the-Drunken-coder/dual-band-radio-lab/hardware/carrier-rev-a/README.md

# carrier-rev-a

Editable Rev A schematic, routed PCB, selected BOM and schematic PDF. Native KiCad ERC and DRC pass with zero findings, including schematic parity. Two layers, 2 oz copper per side. Review only; no manufacturing release.

Open [carrier-rev-a.kicad_pcb](carrier-rev-a.kicad_pcb) in KiCad. The final native board is authoritative; do not overwrite it with the intermediate router session. See the hardware DESIGN_REVIEW.md, POWER_BUDGET.md and ASSEMBLY_NOTES.md for access, route lengths, power estimates and later physical acceptance.
