the-Drunken-coder/dual-band-radio-lab/hardware/FOOTPRINT_REVIEW.md

# Footprint and component review

Reviewed 2026-09-17 against manufacturer drawings and the actual KiCad 10.0.6 library files. `validation/footprint-geometry.json` records pad numbers, coordinates, sizes and finished drill diameters read by KiCad's footprint loader. Custom and standard footprints are now placed in the four routed review boards. Standard-library names alone were not treated as dimensional evidence.

All coordinates below are mm. Pad dimensions are copper, not solder-mask openings. Library land patterns are engineering choices unless explicitly identified as manufacturer recommendations. Board-level courtyard/access review is recorded in DESIGN_REVIEW.md; fabrication process acceptance remains pending.

| Selected part / footprint | Manufacturer check | Actual footprint and disposition |
| --- | --- | --- |
| Samtec SSQ-108/110/120-01-G-S | SSQ drawing Rev BH: 2.54 pitch, 2.41 body width, length N x 2.54 + 0.51, 8.51 body height, 2.64 solder tail. SSQ PCB drawing: 1.02 holes | Custom SSQ rows use 1.02 finished holes and 1.90 lands; body dimensions match. Carrier slot 8/10 and Pico 20 positions; Core sockets 8 positions |
| Samtec TSW-108/110-07-G-S | TSW drawing Rev DS: 2.54 pitch/body height/width, 5.84 mating post, 2.54 solder tail. Manufacturer footprint: 1.02 holes | Custom TSW rows use 1.02 holes/1.90 lands. Standard fully populated parts, no omitted-pin key |
| Pico 2 with headers SC1632 | Pico 2 mechanical drawing: 21 x 51 board, 2.54 pitch, 17.78 between header rows | No module land pattern: plug-in U1 and two real SSQ-120 sockets. Left J10 1-20 follows Pico 1-20; right J11 1-20 follows Pico 21-40. Right socket runs in the opposite geometric direction in top view, so J11 pin 20 is beside USB |
| Core2021-HF-M, Waveshare SKU 34523 | Waveshare 2D drawing: 22.01 x 18.45 board, 2.54 pitch, 15.24 between rows; vendor schematic U2 header numbers | Plug-in module, two SSQ-108 sockets. J3 1-8 maps module 1-8, J4 1-8 maps 9-16. Preserve the module top-view numbering, with the opposing row reversed geometrically |
| E22-900M30S / RadioLab:E22_900M30S | Ebyte manual PDF p10, section 3.3: 24 x 38.5, groups at 2.54 pitch with 7.60 group gap; terminal contact 1.25 x 1.5 | Top-view pin 12 at upper left, 11 upper right, counts toward 22/1 at lower end. Edge-centered lands 2.50 x 1.80 extend 1.25 beyond module. First y=2.61. Chained bottom pad is y=33.07; the separately rounded 5.46 bottom dimension gives 33.04. The 0.03 discrepancy is inside the drawing's 0.1 tolerance and the enlarged lands. Do not use a generic E22 footprint |
| E28-2G4M27S / RadioLab:E28_2G4M27S | Exact 27S manual PDF p5: 15 x 26.5, 1.27 pitch, terminal 1.0 x 0.8, first pad offset 2.69 | Left pins 1-8, right 16-9. Edge lands 2.00 x 0.90. Last y=11.58; separately rounded bottom dimension differs by 0.02. The download labeled 12S/20S was not reused. Preserve module antenna clearance and underside routing restrictions |
| Phoenix Contact 1757242 | Manufacturer dimensional data: 12.16 width, 12 depth, 8.57 installed height, 5.08 pitch, 1 x 1 tails and 1.4 hole | Exact named KiCad horizontal footprint: 5.08 pitch, 1.4 drill, 2.08 x 3.60 pads. 1757019 is the manufacturer-listed cable mate; no PCB footprint for the cable plug |
| TPS259470LRPWR | TI RPW0010A, PDF pp72-73: 2 x 2 VQFN-HR, ten terminals; two long power strips, no exposed ground pad | Custom land pattern follows p73: IN5/OUT6 at x=+/-0.25, 0.30 x 2.40; side fingers at x=+/-0.90; compound L corners use overlapping same-number pads. GND is pin 8 only. Square corners substitute for the drawing's small corner radius without changing land extents |
| DMG2305UX-7 | Diodes DS36196 SOT23, pin 1 gate, 2 source, 3 drain, 0.95 pitch, approximately 2.9 x 1.3 body | SOT-23: pads 1/2 at x=-0.9375, y=+/-0.95, 1.475 x .60. Numbering checked, especially intentional external-power drain connection |
| AP2112K-3.3TRG1 | Diodes SOT25 package, 0.95 pitch, approximately 2.9 x 1.6 body, pin 4 NC | SOT-23-5: pad x=+/-1.1375, 1.325 x .60, 0.95 pitch. Lead reach/width fit; selected package is K/SOT25, not an alternate AP2112 package |
| AP63203WU-7 | Diodes TSOT26 package: 0.95 pitch, 2.9 x 1.6 body, six leads, 1.0 max height | TSOT-23-6: 1.325 x .60 lands at x=+/-1.1375. Pin 1 FB, 2 EN, 3 VIN, 4 GND, 5 SW, 6 BST checked against manufacturer pin table |
| MCP23S17-E/SO | Microchip DS20001952C p31: 28-pin SOIC, 7.50 x 17.90 nominal body, 1.27 pitch; p32 nominal pad-row centers 9.40, pads 2.00 x .60 | SOIC-28W standard footprint uses 9.30 row centers and 2.05 x .60 lands. Its inner edges extend 0.075 farther inward and outer edges 0.025 less outward than the recommendation, while retaining lead coverage. Accepted engineering IPC-style land pattern, not an exact copied drawing |
| SN74LVC8T245PWR | TI PW0024A TSSOP: 4.4 x 7.8 body, 0.65 pitch; drawing and pin table in SCES584D | TSSOP-24: x=+/-2.8625, 1.475 x .40 lands, 0.65 pitch. Both VCCB pins 23/24 and GND11/12/13 included |
| SN74LVC1T45DBVR | TI DBV0006A SOT23-6, 2.9 x 1.6 body, 0.95 pitch | SOT-23-6: same six-pad geometry as above; pin 1 VCCA, 6 VCCB, 5 DIR checked |
| Coilcraft XAL5030-472MEC | Manufacturer XAL50xx p4: 5.28 x 5.48 +/-0.20, 3.1 max high; recommended lands 1.18 x 4.70, centers 3.31 apart | Exact KiCad XAL5030 footprint matches the recommended lands. Its 5.48 x 5.68 Fab rectangle represents maximum body dimensions |
| Murata GRM188R71H104KA93D / GRM188R71H103KA01D | 100 nF / 10 nF, 50 V X7R, 0603 1.6 x .8 bodies; exact Murata reference sheets | C_0603: lands .90 x .95, centers 1.55 apart, compatible with terminations. 100 nF sheet is a saved Murata document from RS's mirror |
| Murata GRM21BR71C105KA01L | 1 uF, 16 V X7R, 0805 2.0 x 1.25 body | C_0805: 1.00 x 1.45 lands, centers 1.90 apart; used only before the carrier eFuse |
| TDK C3225X7R1E226M250AB | Manufacturer product page and characterization sheet: 22 uF, 25 V X7R, 20%; 3.2 +/- .4 x 2.5 +/- .3, height 2.5 +/- .3, termination >=.2; status Production | C_1210: lands 1.15 x 2.70, centers 2.95 apart. Accepted IPC-style footprint with ample terminal overlap; not claimed identical to TDK's suggested land pattern. Replaces the earlier Murata E20/E15 candidates, whose lifecycle data showed discontinuation notices. Online primary evidence recorded in sources/online-evidence.md |
| Panasonic EEEFK1A221P | FK manufacturer catalog p12 land table size E: 8 mm can, 6.2 nominal / 6.5 maximum height, 8.3 mm base; 2.2 mm gap, 4.0 mm land length, 1.6 mm land width | Custom RadioLab:Panasonic_FK_E_8x6.2 matches those lands at +/-3.10. The generic KiCad footprint's 2.1 mm gap and 2.5 mm width were replaced. Pin 1 positive, pin 2 negative; polarized schematic symbol explicitly marked |
| Yageo RC0603FR-07... | RC series drawing: 1.60 +/- .10 x .80 +/- .10, .45 +/- .10 high; 1%, 0.1 W | R_0603: .80 x .95 lands at +/- .825. Exact suffixes for 715 ohm, 1k, 10k, 100k, 267k are recorded in each BOM |
| Yageo RT0603BRD07340KL / RT0603BRD07100KL | RT series, same 0603 body; 0.1%, 25 ppm/K | Same R_0603 geometry; selected for OVLO-divider tolerance |
| Accu SSCF-M3-25-A2 / HPN-M3-A2 | Manufacturer own-brand product datasheets: full M3x25 thread, 5.5 diameter x 3 high head; 5.5 AF x 2.4 nut | Custom 3.4 NPTH with 7 mm keepout; nut is an assembly accessory, not a second footprint. Asymmetric coordinates and tolerance arithmetic in radio-slot-v0.1.md |

Primary online dimensional sources: [Phoenix 1757242](https://www.phoenixcontact.com/en-us/products/pcb-header-mstba-25-2-g-508-1757242?type=pdf), [Accu post](https://www.accu.co.uk/api/product-datasheet?id=642039), [Accu nut](https://www.accu.co.uk/hexagon-nuts/7888-HPN-M3-A2), [TDK 22 uF / 25 V](https://product.tdk.com/en/search/capacitor/ceramic/mlcc/info?part_no=C3225X7R1E226M250AB). Other primary documents are saved in `sources/` with URLs in the manifest. Download failures do not change into claimed local files.

The H1 alignment-hole item on each daughtercard is a board feature and excluded from its procurement BOM. Pico/Core symbols are purchased plug-in assemblies and have no solder footprint; their actual sockets do. Clamp nuts and the power cable plug similarly have no independent PCB footprint. No electrical component has an unresolved MPN or footprint.

## SPI series resistor additions

RC0603FR-0722RL, 22 ohms / 1% / 0.1 W, and the alternate RC0603JR-070RL 0-ohm jumper both use Yageo's 1.60 +/-0.10 x 0.80 +/-0.10 mm RC0603 body, 0.45 +/-0.10 mm thick. Their manufacturer part-specific sheets confirm the same mechanical dimensions, so both fit the already reviewed R_0603_1608Metric lands without a new footprint. [22-ohm manufacturer sheet](https://yageogroup.com/component-documentation/download/specsheet/RC0603FR-0722RL), [0-ohm manufacturer sheet](https://yageogroup.com/component-documentation/download/specsheet/RC0603JR-070RL). Only the 22-ohm initial population is counted in each BOM; the 0-ohm alternate is recorded in its assembly field.

## Added probe features and 3D access review

Keystone **5011** black multipurpose test points use a 1.6 mm finished hole, 3.17 mm base and 8.13 mm overall reference height. The KiCad `TestPoint_Keystone_5010-5014_Multipurpose` pad/drill geometry matches those dimensions. The 5011 is factory-fitted at the power entry, each carrier slot and each card ground clip. [Manufacturer dimensions](https://www.keyelco.com/category.cfm/Test-Points-color-keyed-Thru-Hole-Mount/Multipurpose-Style/id/748), [5011 product page](https://www.keyelco.com/product.cfm/product_id/1320).

Other probes are project-local 1.0 mm circular copper pads with mask openings and no paste/body courtyard. The E28 SW probe is 0.6 mm to fit clear of the inductor body; it is a board feature, not an assembled component. Copper/mask clearance DRC applies to every probe. The alignment-hole courtyard is the actual specified 7 mm exclusion diameter.

`RadioLab.3dshapes/` contains dimensioned review envelopes for modules, sockets/headers, Pico/Core plug-ins, post hardware, bulk capacitor, eFuse and 5011. Standard supported KiCad STEP models are used for the remaining packages. Envelope models show connector access and installed heights but are not substitutes for supplier CAD, insertion-force tests or the acceptance checks in ASSEMBLY_NOTES.md.
