the-Drunken-coder/dual-band-radio-lab/hardware/sources/online-evidence.md

# Online primary-source evidence

Read 2026-09-17. These entries deliberately do not claim a successfully saved PDF when direct download failed.

- [TDK C3225X7R1E226M250AB product page](https://product.tdk.com/en/search/capacitor/ceramic/mlcc/info?part_no=C3225X7R1E226M250AB): status Production, 22 uF +/-20%, 25 V X7R. Body 3.20 +/-0.40 by 2.50 +/-0.30, thickness 2.50 +/-0.30 mm; terminal width >=0.20 mm. Reflow. [Manufacturer characterization sheet, 2022-02-16](https://product.tdk.com/system/files/dam/doc/product/capacitor/ceramic/mlcc/charasheet/c3225x7r1e226m250ab_220216.pdf) repeats dimensions and ratings. Web tool read the one-page PDF; shell download returned HTTP 403. No minimum capacitance under bias was inferred from an unviewed graph. POWER_BUDGET.md explicitly identifies its combined bias/aging allowance as an engineering bound to verify.
- [Phoenix 1757242 manufacturer PDF](https://www.phoenixcontact.com/en-us/products/pcb-header-mstba-25-2-g-508-1757242?type=pdf): 12 A, 5.08 mm pitch, 12.16 x 12 mm body, 8.57 installed height, 3.23 mm solder pins, 1 x 1 mm terminals, 1.4 mm finished hole. Manufacturer catalog names mating 1757019. Web tool read the PDF; shell download returned HTTP 403.
- [Accu SSCF-M3-25-A2](https://www.accu.co.uk/api/product-datasheet?id=642039): manufacturer own-brand full-thread M3 x 25, 0.5 mm pitch, A2 stainless, DIN912/ISO4762, head 5.5 mm diameter +0/-0.18 and 3 mm high +0/-0.14. Web search returned the product datasheet; shell download returned HTTP 403.
- [Accu HPN-M3-A2](https://www.accu.co.uk/hexagon-nuts/7888-HPN-M3-A2): M3, 0.5 mm pitch, 5.5 mm across flats +0/-0.18, 2.4 mm height +0/-0.25. No stock commitment is inferred from the page's dynamic purchase controls.

Murata GRM32ER61C226KE20L and GRM32ER61E226KE15L were considered, but subsequent lifecycle/discontinuation evidence and unavailable reference-sheet URLs led to selecting the currently listed TDK part instead. They are not substitute BOM entries.

## SPI resistor options

Read 2026-09-17 from Yageo's exact part sheets: [RC0603FR-0722RL](https://yageogroup.com/component-documentation/download/specsheet/RC0603FR-0722RL) is 22 ohms, 1%, 0.1 W; [RC0603JR-070RL](https://yageogroup.com/component-documentation/download/specsheet/RC0603JR-070RL) is the matching 0-ohm jumper. Both specify a 1.6 +/-0.1 by 0.8 +/-0.1 mm body, 0.45 +/-0.1 mm thick, compatible with the selected 0603 footprint. These primary online sheets supplement the saved RC-series datasheet.

## Layout probe and regulator references, 2026-09-17

- Keystone 5011: https://www.keyelco.com/category.cfm/Test-Points-color-keyed-Thru-Hole-Mount/Multipurpose-Style/id/748 and https://www.keyelco.com/product.cfm/product_id/1320 . Black multipurpose point, 1.6 mm hole, 3.17 mm base and 8.13 mm reference height. The stock 5010-5014 footprint matches; a local dimensioned review model supplies the otherwise missing 5011 3D envelope.
- AP63203 DS41326 Rev 3-2 Figure 25: https://www.diodes.com/datasheet/download/AP63200-AP63201-AP63203-AP63205.pdf . Compared against the routed local input, SW/inductor, output-ground and bottom feedback paths. Evaluation board: https://www.diodes.com/assets/Evaluation-Boards/AP63203-EVB-User-Guide.pdf . Both-side 2 oz copper and short hot-loop guidance retained.
