the-Drunken-coder/dual-band-radio-lab/prototype/dual-lr2021-usb-carrier/extra/references/radio/Core2021-HF-Schematics.txt

1
2
3
4
GND
4
DIO8
10
DIO7
11
GND
Osc1
XTA
1 GND 2
OSC1
C1
4 OSC2 3
C2
GND
12PF
12PF
A A
ANT_HF 2.4GHz
32MHz(2.0*1.6) 10PF
XTB
GND
GND
GND
GND GND GND
GND GND
GND GND
VR
VNTC
C3
_
PA
R1
C4
C5
120K
47pF/50V
L1
C6
L2
18nH
D1
NTC
C7
NC
NTC1
2.2uF/6.3V
1nF/16V
2.2pF
1.2pF
1pF
NC
NC
RClamp1561PWQ
C12
C8
1.1pF C9
C10
C11
L3
L4
L5
2.4G
ANT
1
_
DIO10
DIO11
VNTC
XTB
XTA
NTC
VPAX
VR
1.5nH
1.6nH
1.1nH
C13
6.8pF
_
L6
2 3
ANT1
贴片天线座IPEX 4代
PA
B B
GND
GND
DIO10 8
DIO11 7
DIO9
9
DIO9
DIO8
VTCXO/VNTC 6
XTB 5
XTA 4
NTC 3
VPAX2 2
PA 1
U1
2.4nH C14
18pF
LR2021
NC
_
VR
RFO
HF 32
_
GND
RFI_HF 31
DIO7
GND 30
GND
C15
C16
ANT_HF SubGHz - 868/915MHz
L7
2.2pF
VDCC1
VPAX1
GND 0
RFI_LF 29
24nH
RFO
LF1 28
_
L8
L10
LXB
RFO
LF2 27
LORA
ANT
1
_
_
C20
3.9nH
4.7nH
15
GND
DCC
VDCC2 26
VDCC
22pF C21
C25
C22
7.5nH C23
L11
C24
2 3
ANT2
4
贴片天线座IPEX 4代
_
L12
LXA
16
LXA
BUSY 25
BUSY
1uF
12nH
7.5pF
3.9pF
1.8pF
22nH
NC
D2
GND
C C
VBAT
DIO6
DIO5
NRESET
GND
1.8pF
RClamp1561PWQ
MISO
MOSI
SCK
C26
NSS
GND
VR
47pF
_
GND
L13
17
18
19
20
21
22
23
24
PA
GND
GND
GND
GND
GND
GND
LXA
LXB
贴片电感 2.2uH 0603
C27
3V3
DIO6
DIO5
100nF/16V
NRESET
MISO
MOSI
SCK
U2
R2
2.4G
ANT
1
_
2.4G
ANT
_
LoRa_ANT 16
R3 NC/0R LORA
ANT
_
2
GND
GND C29
100nF/16V
NC/0R
GND
GND 15
C28
3
DIO11
NSS 14
R4 0R
NSS
4
DIO8
SCK 13
R5 0R
SCK
4.7uf/6.3V
5
DIO7
MOSI 12
MOSI
GND
D D
CESD3V3D3(打字YU)
6
NC
MISO 11
7
GND
RESET 10
3V3
8 BUSY 9
3V3
1 2
D3
Core2021-XF
C17 1uF/6.3V VDCC
12
GND
C18 2.2uF/6.3V
VPAX
13
18pF
C19
L9
LXB
14
NSS
GND DIO11
DIO8
DIO7
NC
R6 0R
MISO
GND
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
PANTC101
PAR301
PAR201
PAR401
PAR501
PAR601
PAR701
PAR801
PAR101
PAC2602 PAC2601COC26
PAANT203
PAC2002 PAC2001COC20
PAANT201COANT2
PAANT204
PAR301
PAR302COR3
PAANT202
PAU2015
PAU2015
PAU209
PAU209
PAU2010
PAU2010
PAU2011
PAU2011
PAU2012
PAU2012
PAU2013
PAU2013
PAU2014
PAU2014
PAU2016
PAU2016
