the-Drunken-coder/dual-band-radio-lab/prototype/dual-lr2021-usb-carrier/extra/references/controller-power/extracted/controller-schematic.txt

--- PAGE 1 ---
1
1
2
2
3
3
4
4
5
5
6
6
D
D
C
C
B
B
A
A
aveshare
W
ESP-32S
HUB
USB to UART
VDDUSB
DTR
RTS
AUTO PROGRAM CIRCUIT
 
DTR   RTS    RST   GPIO0  GPIO2
  1         1          1          1         1
  0         0          1          1         1
  1         0          0          1         1
  0         1          1          0         0
Key
GND
#EN
GND
IO0
S2
KEY_RST/USER
S1
KEY_FLASH
#EN
IO0
VT1
S8050
VT2
S8050
D_P
D_N
VDD3V3
VDD3V3
ESP32-S3-DEV-KIT-N8R8
GND
GND
GND
0
VIO
1
GND
2
VDD
3
TXD
4
RXD
5
V3
6
UD+
7
UD-
8
VBUS
9
ACT#
10
DCD
11
DTR
12
RTS
13
DSR
14
CTS
15
RI
16
U4
CH343P
RTS
DTR
GND
A1/B12
VBUS
A4/B9
CC1
A5
DN2
B7
DP1
A6
DN1
A7
SBU1
A8
GND
A12/B1
VBUS
A9/B4
CC2
B5
DP2
B6
SBU2
B8
GND
MTB
H1
USB_TYPE_C_16PIN
GND
GND
GND
GND
ESP32-S3-WROOM-1-N8R8
GND
1
3V3
2
EN
3
IO4
4
IO5
5
IO6
6
IO7
7
IO15
8
IO16
9
IO17
10
IO18
11
IO8
12
IO19
13
IO20
14
IO3
15
IO46
16
IO9
17
IO10
18
IO11
19
IO12
20
IO13
21
IO14
22
IO21
23
IO47
24
IO48
25
IO45
26
IO0
27
IO35
28
IO36
29
IO37
30
IO38
31
IO39
32
IO40
33
IO41
34
IO42
35
RXD0
36
TXD0
37
IO2
38
IO1
39
GND
40
EP
41
U1
ESP32-S3-WROOM-1-N8R8
1
2
3
4
5
6
7
8
9
10
11
12
13
14
15
16
17
18
19
20
21
22
P1
Header 22
1
2
3
4
5
6
7
8
9
10
11
12
13
14
15
16
17
18
19
20
21
22
P2
Header 22
GPIO0
GPIO1
GPIO2
GPIO3
GPIO4
GPIO5
GPIO6
GPIO7
GPIO8
GPIO9
GPIO10
GPIO11
GPIO12
GPIO13
GPIO14
GPIO15
GPIO16
GPIO17
GPIO18
GND
GND
CHIP_PU
GPIO46
GPIO45
U0RXD
U0TXD
GPIO21
GPIO20
GPIO19
GPIO48
GPIO47
GPIO35
GPIO36
GPIO37
GPIO38
GPIO39
GPIO40
GPIO41
GPIO42
VBUS
GND
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
PIR701
PIU1036
NLU0RXD
PIP202
PIR801
PIU1037
NLU0TXD
PIU309
PIU408NLUSB20N
PIU3010
PIU407
NLUSB20P
PIU305
NLUSB40N
PIU306
NLUSB40P
PIC1302
PID101
PIH10A40B9
PIH10A90B4
PIR1401
PIU409
NLVBUS
PIC102
PIC402
PID102
PIP1021
PIU203
NLVCC05V
PIC1801
PIR1601
PIU304
PIX101
NLXI
PIR1501
PIR1602
PIU303
NLXO
