the-Drunken-coder/dual-band-radio-lab/hardware/Rev-A-electrical-studies.pdf

1 | 2 | 3 | 4 | 5 | 6 | 7 | 8 | 9 | 10 | 11 | 12 | 13 | 14 | 15 | 16 | 17 | 18 | 19 | 20 | 21 | 22 | 23
1 | 2 | 3 | 4 | 5 | 6 | 7 | 8 | 9 | 10 | 11 | 12 | 13 | 14 | 15 | 16 | 17 | 18 | 19 | 20 | 21 | 22 | 23

AB

C

D

E

### FGH

### IJK

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
### FGH

### IJK

LM

N

O

## P Date: 2026-09-17

## KiCad E.D.A. 10.0.6

Size: A0 | Rev: A-schematic Id: 1/1

# Title: Four-slot carrier: protected external 5 V / 4 A, isolated GPIO

## File: carrier-rev-a.kicad_sch

## Sheet: /

## SCHEMATIC REVIEW - NOT FOR FABRICATION

GP0 1 | GP1 2 | GND 3 | GP2 4 | GP3 5 | GP4 6 | GP5 7 | GND 8 | GP6 9 | GP7 10 | GP8 11 | GP9 12 | GND 13 | GP10 14 | GP11 15 | GP12 16 | GP13 17 | GND 18 | GP14 19 | GP15 20 | GP16 | 21 GP17 | 22 GND | 23 GP18 | 24 GP19 | 25 GP20 | 26 GP21 | 27 GND | 28 GP22 | 29 RUN | 30 GP26 | 31 GP27 | 32
AGND | 33 GP28 | 34
ADC_VREF | | 35
3V3_OUT | | 36
3V3_EN | 37 GND | 38
VSYS | 39
VBUS | 40 U1 Pico 2 with headers, SC1632
PROBE 1 | TP45 P_MOSI
PROBE 1 | TP1

### S1_5V

PROBE 1 | TP33

### VBUS

PROBE 1 | TP25

### S4_BUSY

PROBE 1 | TP49 MISO
PROBE 1 | TP41

### EXP_CS

PROBE 1 | TP17

### S3_BUSY

PROBE 1 | TP51 U3_GND
PROBE 1 | TP43 OE_N
PROBE 1 | TP11

### S2_BUSY

PROBE 1 | TP3

### S1_BUSY

PROBE 1 | TP50

### ENTRY_GND

PROBE 1 | TP34

### VSYS

PROBE 1 | TP18

### S3_IRQ

PROBE 1 | TP26

### S4_IRQ

PROBE 1 | TP42
EXP_RST | PROBE 1 | TP35 PICO_3V3
PROBE 1 | TP27

### S4_RESET_N

PROBE 1 | TP19

### S3_RESET_N

PROBE 1 | TP10

### S2_CS_N

H2 Captive M3 x 25 alignment post PROBE 1 | TP2

### S1_CS_N

1

1
2

2 R1
267k

1

1
2

2 R10
100k

1

1
2

2 C10

100nF ⁺

1 | -

2 C3
220uF

H1 Captive M3 x 25 alignment post

1

1
2

2 R14
10k

1

1
2

2 R16
10k

1

1
2

2 R12
1k

1

1
2

2 C11
100nF

1

1
2

2 C4
22uF

1

1
2

2 R15
10k

1

1
2

2 R11
1k

VCCA 1 DIR 2

A1 3

A2 4

A3 5

A4 6

A5 7

A6 8

A7 9

A8 10 | GND 11 | GND 12 | GND | 13 B8 | 14 B7 | 15 B6 | 16 B5 | 17 B4 | 18 B3 | 19 B2 | 20 B1 | 21 OE_N | 22
VCCB | 23
VCCB | 24 U6

### SN74LVC8T245PWR

1

1
2

2 R21
22

1

1
2

2 R3
340k 0.1%

1

1
2

2 C12
100nF

1

1
2

2 C5
22uF

VCCA 1 DIR 2

A1 3

A2 4

A3 5

A4 6

A5 7

A6 8

A7 9

A8 10 | GND 11 | GND 12 | GND | 13 B8 | 14 B7 | 15 B6 | 16 B5 | 17 B4 | 18 B3 | 19 B2 | 20 B1 | 21 OE_N | 22
VCCB | 23
VCCB | 24 U5

### SN74LVC8T245PWR

1

1
2

2 R2
100k

1

1
2

2 R20
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
8 J4

### SSQ-108-01-G-S

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
10 10 J3

### SSQ-110-01-G-S

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
10 10 J1

### SSQ-110-01-G-S

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
8 J2

### SSQ-108-01-G-S

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
10 10 J5

### SSQ-110-01-G-S

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
8 J6

### SSQ-108-01-G-S

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
8 J8

### SSQ-108-01-G-S

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
10 10 J7

### SSQ-110-01-G-S

EN_UVLO

1 OVLO

2

AUXOFF 3

| FLT_N

4

IN

5 | OUT | 6 DVDT | 7 GND

8

ILM

9

ITIMER

10 U2

### TPS259470LRPWR

GPB0

1 | GPB1
2 | GPB2
3 | GPB3
4 | GPB4
5 | GPB5
6 | GPB6
7 | GPB7

8

| VDD

9

VSS

10 CS_N

11

| SCK

12

SI 13

SO

14

A0

15

A1

16

A2

17 RESET_N

18

INTB

19

INTA 20 GPA0

21 GPA1

22 GPA2

23 GPA3

24 GPA4

25 GPA5

26 GPA6

27 GPA7

### 28 U4 MCP23S17-E/SO

1

1
2

2 C2
1uF

1

1
2

2 R19
100

1

1
2

2 C9
100nF

1

1
2

2 R9
10k

1

1
2

2 R8
10k

1

1
2

2 C8

100nF | MP5 External cable mating plug

1

1
2

2 C1

10nF | MP3 M3 captive⁻post clamp nut MP1 M3 captive⁻post clamp nut MP2 M3 captive⁻post clamp nut MP4 M3 captive⁻post clamp nut
PROBE 1 | TP9

### S2_5V

PROBE 1 | TP21

### S3_RX_EN

PROBE 1 | TP13

### S2_RESET_N

PROBE 1 | TP5

### S1_RESET_N

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
10 10

11 | 11
12 | 12
13 | 13
14 | 14
15 | 15
16 | 16
17 | 17
18 | 18
19 | 19
20 | 20 J10

### SSQ-120-01-G-S

PROBE 1 | TP37 UVLO
PROBE 1 | TP44 P_SCK
PROBE 1 | TP29

### S4_RX_EN

PROBE 1 | TP22

### S3_GND

PROBE 1 | TP30

### S4_GND

PROBE 1 | TP46 P_MISO
PROBE 1 | TP38 OVLO
PROBE 1 | TP14

### S2_GND

PROBE 1 | TP6

### S1_TX_EN

PROBE 1 | TP47

### SCK

PROBE 1 | TP39 DVDT | PROBE 1 | TP48 MOSI PROBE 1 | TP32 BUS_5V
PROBE 1 | TP40

### ILIM

PROBE 1 | TP31

### IN_5V

PROBE 1 | TP23

### S4_5V

PROBE 1 | TP15

### S3_5V

PROBE 1 | TP7

### S1_RX_EN

PROBE 1 | TP24

### S4_CS_N

PROBE 1 | TP8

### S1_GND

PROBE 1 | TP16

### S3_CS_N

G

1

S

2 | D

### 3 Q1 DMG2305UX-7

POWER

1 | #FLG03 POWER DECLARATION: PICO_VSYS

1

1
2

2 R22
22

1

1
2

2 J9

### 5 V / 4 A INPUT

VIN

1 GND

2

| EN
3 | NC

4

VOUT 5 U3

### AP2112K-3.3TRG1

PROBE 1 | TP12

### S2_IRQ

PROBE 1 | TP4

### S1_IRQ

PROBE 1 | TP36

### IOREF_3V3

PROBE 1 | TP28

### S4_TX_EN

PROBE 1 | TP20

### S3_TX_EN

H4 Captive M3 x 25 alignment post

1

1
2

2 R18
10k

1

1
2

2 R6
10k

1

1
2

2 R13
10k

1

1
2

2 R17

### 10k H3 Captive M3 x 25 alignment post

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
10 10

11 | 11
12 | 12
13 | 13
14 | 14
15 | 15
16 | 16
17 | 17
18 | 18
19 | 19
20 | 20 J11

### SSQ-120-01-G-S

1

1
2

2 R7
100k

1

1
2

2 C6
100nF

1

1
2

2 R4
100k 0.1%

1

1
2

2 C7
100nF

1

1
2

2 R5
715

POWER

1 | #FLG02 POWER DECLARATION: GND

POWER

1 | #FLG01 POWER DECLARATION: EXT_5V
VCCA 1 | GND

2

A 3 | B

4 DIR

5

VCCB

6 U7

### SN74LVC1T45DBVR

RADIO_5V

GND

S2_RESET_N

P_EXP_RESET_N

P_IO_OE_N

GND

USB_VBUS

S4_BUSY

GND

P_SPI_SCK

EXP_CS_N

SPI_MISO

P_SPI_MOSI | GND

S3_BUSY

GND

PICO_3V3 GND

PICO_VSYS USB_VBUS

RADIO_5V | PICO_VSYS

EXP_RESET_N

S4_IRQ

S3_IRQ

P_S3_IRQ

GND

S1_BUSY

S3_IRQ

S3_BUSY S2_IRQ

S2_BUSY S1_IRQ

S2_BUSY

P_S3_BUSY GND

GND

P_S4_IRQ

P_S4_BUSY P_S2_CS_N

P_IO_OE_N

PICO_3V3

P_S3_CS_N

S1_BUSY P_IO_OE_N

S3_RESET_N

IOREF_3V3

S4_RESET_N

# IOREF_3V3 GND

S4_IRQ

S4_BUSY | PICO_3V3 P_SPI_MISO

EXT_5V

GND

S1_CS_N

GND

P_S4_CS_N

GND

S2_CS_N

P_EXP_CS_N

UVLO

SPI_MISO

EXT_5V

GND

GND

P_S1_CS_N

IOREF_3V3

GND

GND

ILIM

IOREF_3V3

IOREF_3V3 | GND
RADIO_5V | GND

EXP_RESET_N

PICO_3V3

SPI_MISO

GND

USB_VBUS

P_S1_IRQ

PICO_VSYS

PICO_3V3

# USB_VBUS PICO_3V3

P_S3_CS_N

P_IO_OE_N

SPI_MOSI

GND

OVLO

IOREF_3V3

P_S2_CS_N

GND

P_S1_BUSY

GND

P_S2_IRQ

GND

PICO_3V3 GND

PICO_3V3

GND

P_EXP_RESET_N

GND

# PICO_3V3 RADIO_5V UVLO

P_S2_BUSY

PICO_3V3

PICO_3V3

P_SPI_MISO

RADIO_5V | GND

P_S1_CS_N

GND

P_S4_IRQ

P_S4_CS_N | PICO_3V3 | P_EXP_CS_N

P_S4_BUSY P_S3_IRQ

S1_RESET_N

P_S3_BUSY P_S2_IRQ

S2_RESET_N

P_S2_BUSY

S3_RX_EN

S4_RX_EN

P_S1_IRQ

S3_TX_EN

P_S1_BUSY GND

S4_TX_EN

PICO_3V3

IOREF_3V3

EXT_5V

# IOREF_3V3 P_SPI_SCK

GND

GND

P_SPI_MOSI

IOREF_3V3

UVLO

IOREF_3V3 | OVLO

S2_IRQ

S1_IRQ

GND

SPI_MOSI_SRC

GND

IOREF_3V3

GND

SPI_SCK_SRC

GND

GND

SPI_MOSI SPI_MISO

S2_CS_N

S2_RESET_N

GND

P_EXP_RESET_N

P_EXP_CS_N

P_S4_CS_N

P_S3_CS_N

P_S2_CS_N

EXT_5V

P_SPI_MOSI

IOREF_3V3

P_SPI_SCK

GND

GND

PICO_3V3

EXT_5V

PICO_3V3 | GND

SPI_SCK

RADIO_5V GND

S2_IRQ

RADIO_5V | PICO_VSYS
S2_BUSY | SPI_MISO

SPI_SCK

GND

RADIO_5V | RADIO_5V DVDT GND

ILIM

RADIO_5V GND

GND

S1_RESET_N

S1_CS_N

USB_VBUS | RADIO_5V SPI_MISO | PICO_VSYS

GND

SPI_MOSI S1_BUSY SPI_SCK

EXP_MISO_SRC

GND

RADIO_5V

GND

RADIO_5V

P_IO_OE_N

GND

P_EXP_RESET_N

RADIO_5V

S1_RX_EN

S3_CS_N

P_SPI_MOSI

S4_CS_N

P_SPI_SCK

S1_TX_EN

GND

S1_IRQ

ILIM

GND

S3_RESET_N

SPI_MOSI

S3_CS_N

SPI_MISO

SPI_MOSI

SPI_SCK

RADIO_5V GND

IOREF_3V3 GND

IOREF_3V3

IOREF_3V3 P_IO_OE_N

SPI_SCK_SRC

SPI_MOSI_SRC

S1_CS_N

GND

S2_CS_N

S3_CS_N

S4_CS_N

EXP_CS_N

EXP_RESET_N

GND

IOREF_3V3

S3_RX_EN | GND

S3_TX_EN

S4_RX_EN

S3_IRQ

# S3_BUSY SPI_SCK

GND

S1_TX_EN

S1_RX_EN

S3_TX_EN

S3_RX_EN

S4_TX_EN

RADIO_5V | S4_TX_EN

S4_IRQ

S4_RX_EN

GND

GND

GND

S4_RESET_N

S4_CS_N

SPI_MISO

SPI_MOSI

OVLO

P_S1_CS_N

S4_BUSY

P_SPI_MISO

P_SPI_MISO

SPI_SCK

GND

S1_RX_EN

RADIO_5V

RADIO_5V

RADIO_5V

RADIO_5V

# EXT_5V DVDT

GND

GND

GND

P_S2_BUSY | GND

P_S2_IRQ

S1_TX_EN

GND

P_S1_BUSY P_S1_IRQ

IOREF_3V3

S3_RESET_N

S4_RESET_N

S1_RESET_N

EXT_5V OVLO

DVDT_C

UVLO

GND

P_S3_CS_N

P_S2_CS_N

P_S4_BUSY P_S4_CS_N

GND

IOREF_3V3

GND

EXP_RESET_N

GND

P_S4_IRQ

P_S3_BUSY | GND

PICO_3V3

GND

IOREF_3V3

GND

GND

EXP_CS_N

EXP_MISO_SRC

P_S3_IRQ

SPI_MOSI SPI_SCK

DVDT_C

EXP_CS_N

DVDT

GND

P_EXP_CS_N

P_S1_CS_N

USB-only: Q1 off; RADIO_5V and IOREF_3V3 unpowered. External power: U2 -> radios and Q1 -> VSYS. Q1 orientation is intentional: body diode from RADIO_5V toward VSYS. Pico onboard D1 blocks USB backfeed. #FLG01/#FLG02 model the external supply; #FLG03 models real Q1/onboard USB-D1 ORing output. U2 AUXOFF/FLT/ITIMER unused per datasheet. Leave ITIMER open for fastest current limiting.

## Four-slot carrier: protected external 5 V / 4 A, isolated GPIO

REV A LAYOUT REVIEW. NOT FOR FABRICATION.

18/26 GPIO used; eight spare including GP26-28, all physically NC. BUSY/IRQ/CS are direct GPIO through fixed-direction isolation, not expander GPIO. KEY: captive M3 x 25 alignment post, see radio⁻slot-v0.1.md. U4 GPA0..5 = S1/S3/S4 TX,RX pairs; GPB0..3 = S1..4 RESET_N. No autonomous duty⁻cycled RX or automatic TX/RX transitions on Ebyte cards.

R20/R21: immediately after U5 SCK/MOSI outputs. R22: at U4 SO before shared MISO. 22R initial; 0R population option. Verify by oscilloscope/IBIS. No long stubs. Each radio card has its own MISO source resistor before slot A7.

Local labels connect equal names. NC marks deliberate unused module pins. Selected parts: see BOM, FOOTPRINT_REVIEW.md and ASSEMBLY_NOTES.md.

1 | 2 | 3 | 4 | 5 | 6 | 7 | 8 | 9 | 10 | 11

AB

C

D

E

### FGH

AB

C

D

E

## FGH Date: 2026-09-17

Size: A2 | Rev: A-schematic

# Title: 915 MHz LoRa card

## File: e22-900m30s-rev-a.kicad_sch

1

1
2

2 R1
10k
PROBE 1 | TP6 BUSY
PROBE 1 | TP5 RESET_N
PROBE 1 | TP7

### IRQ

PROBE 1 | TP15

### IOREF

PROBE 1 | TP13 MOD_5V
PROBE 1 | TP11 CLIP_GND
PROBE 1 | TP9 RX_EN
PROBE 1 | TP3

### SPI_MISO

PROBE 1 | TP1

### SPI_SCK

PROBE 1 | TP4 CS_N
PROBE 1 | TP2

### SPI_MOSI

PROBE 1 | TP14 MOD_GND
PROBE 1 | TP12

### AUX0

PROBE 1 | TP10

### IN_5V

POWER 1 | #FLG03 POWER DECLARATION: IOREF_3V3

1

1
2

2 R5
22

1

1
2

2 C3

# 100nF H1 M3 alignment hole

1

1
2

2 R4
10k

1

1
2

2 R2
10k

1

1
2

2 C2
22uF
POWER 1 | #FLG01 POWER DECLARATION: SLOT_5V

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
8 J2

# TSW-108-07-G-S +

1 | -

2 C1
220uF
POWER 1 | #FLG02 POWER DECLARATION: GND
PROBE 1 | TP8

### TX_EN

GND 1 | GND 2 | GND 3 | GND 4 | GND 5 | RXEN 6
TXEN 7 | DIO2 8

VCC 9

VCC 10 | GND 11 | GND | 12 DIO1 | 13 BUSY | 14 NRST | 15 MISO | 16 MOSI | 17
SCK | 18 NSS | 19 GND | 20
ANT | 21 GND | 22 U1

### E22-900M30S

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
10 10 J1

### TSW-110-07-G-S

1

1
2

2 R3
10k

BUSY GND

IOREF_3V3 | CS_N

TX_EN

RESET_N

IRQ SLOT_5V

SPI_MOSI SPI_MISO

CS_N

RESET_N

GND

GND

IOREF_3V3

SLOT_5V

SLOT_5V

SLOT_5V

GND

AUX0 GND

IOREF_3V3 GND

GND

RX_EN

TX_EN

AUX0

SLOT_5V SLOT_5V | RX_EN

SPI_SCK

SPI_SCK

SPI_MISO

GND

CS_N

SPI_MOSI BUSY

GND

AUX0

IRQ

SLOT_5V

CS_N

TX_EN

GND

SPI_MISO_SRC

SPI_SCK

SPI_MOSI GND

GND

GND

GND

GND

SLOT_5V

IOREF_3V3

TX_EN

RX_EN

SPI_MISO

GND

SPI_MISO_SRC

SLOT_5V

GND

RESET_N

BUSY

IRQ

SLOT_5V

GND

GND

GND

RX_EN | GND
IOREF_3V3 | RESET_N KEYED SLOT: H1 engages the carrier M3 x 25 post before electrical contact. All headers and passives factory fitted. No user soldering or antenna⁻selector rework. Power declarations describe power arriving through the slot and buck output after L1. Layout authorized; no fabrication release. See DESIGN_REVIEW.md. MISO: source -> 22R -> slot A7. Fit 0R option; scope/IBIS verify. Place at module output/socket, before shared bus. No long stubs.

REV A LAYOUT REVIEW. NOT FOR FABRICATION.

## 915 MHz LoRa card

Local labels connect equal names. NC marks deliberate unused module pins. Selected parts: see BOM, FOOTPRINT_REVIEW.md and ASSEMBLY_NOTES.md. | Module pad 21 ANT: NC, use module IPEX. Both pads 9 and 10 are VCC. H1 is the mandatory alignment-post hole. DIO2 is AUX0 for a local test point only; do not connect it to a Pico GPIO. AUX1 is reserved. DIO3 is internal TCXO control, configured to 2.2 V.

AB

C

D

E

### FGH

AB

C

D

E

## FGH Date: 2026-09-17

# Title: 915 MHz FLRC socket adapter

## File: core2021-hf-m-rev-a.kicad_sch

ANT_2G4 1 | GND 2 | DIO11 3 | DIO8 4 | DIO7 5 | NC 6 | GND 7
3V3 8 | BUSY | 9 RESET | 10 MISO | 11 MOSI | 12
SCK | 13 NSS | 14 GND | 15
ANT_SUBG | 16 U1 Core2021-HF-M plug-in
PROBE 1 | TP6 BUSY
PROBE 1 | TP5 RESET_N
PROBE 1 | TP7

### IRQ

PROBE 1 | TP15 MOD_GND
PROBE 1 | TP13

### EN_5V

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
10 10 J1

### TSW-110-07-G-S

PROBE 1 | TP11 OUT_3V3
PROBE 1 | TP9 CLIP_GND
PROBE 1 | TP3

### SPI_MISO

PROBE 1 | TP1

### SPI_SCK

PROBE 1 | TP4 CS_N
PROBE 1 | TP2

### SPI_MOSI

PROBE 1 | TP14 MOD_3V3
PROBE 1 | TP12 REG_GND
PROBE 1 | TP10

### AUX0

1

1
2

2 R1
10k

1

1
2

2 C1
22uF

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
8 J3
SSQ-108-01-G-S | H1 M3 alignment hole

1

1
2

2 C4
22uF

1

1
2

2 C3
100nF

1

1
2

2 R3
22
VIN 1 | GND 2
EN 3 | NC | 4
VOUT | 5 U2

### AP2112K-3.3TRG1

PROBE 1 | TP8

### IN_5V

1

1
2

2 R2
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
8 J4

### SSQ-108-01-G-S

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
8 J2

### TSW-108-07-G-S

1

1
2

2 C2
22uF
POWER 1 | #FLG01 POWER DECLARATION: SLOT_5V
POWER 1 | #FLG02 POWER DECLARATION: GND

BUSY SPI_MISO

RESET_N

GND

SLOT_5V

AUX0 | RESET_N

IRQ

GND

GND

SLOT_5V

GND

GND

RADIO_3V3

SLOT_5V

AUX0

GND

SLOT_5V | RADIO_3V3 IRQ

GND

SPI_SCK

SPI_MISO | GND

SPI_MISO

GND

SPI_MOSI SPI_SCK

RADIO_3V3 | CS_N

SPI_MOSI

BUSY | RADIO_3V3 RESET_N

GND

SPI_MISO_SRC

AUX0 CS_N

SLOT_5V GND

RADIO_3V3 | CS_N | RESET_N

GND

SPI_SCK

RADIO_3V3 | GND

GND

SPI_MOSI SLOT_5V | RADIO_3V3

AUX0

SLOT_5V | RESET_N
| SPI_MISO_SRC
| SPI_MOSI SPI_SCK

CS_N

IRQ

GND

RADIO_3V3

BUSY | GND

GND

CS_N

GND

BUSY | SPI_MISO_SRC

RADIO_3V3

GND

SLOT_5V

IRQ

RADIO_3V3 U1 represents the plug-in module, not a soldered module footprint. Socket contacts for module pins 1, 5, 6 and 16 are isolated. TX_EN/RX_EN slot contacts unused. No external RF switch added. J3/J4: 15.24 mm row spacing; top/bottom numbering in FOOTPRINT_REVIEW.md. 915 MHz FLRC socket adapter

KEYED SLOT: H1 engages the carrier M3 x 25 post before electrical contact. All headers and passives factory fitted. No user soldering or antenna-selector rework. Power declarations describe power arriving through the slot and buck output after L1. Layout authorized; no fabrication release. See DESIGN_REVIEW.md. MISO: source -> 22R -> slot A7. Fit 0R option; scope/IBIS verify. Place at module output/socket, before shared bus. No long stubs.

REV A LAYOUT REVIEW. NOT FOR FABRICATION. Local labels connect equal names. NC marks deliberate unused module pins. Selected parts: see BOM, FOOTPRINT_REVIEW.md and ASSEMBLY_NOTES.md.

AB

C

D

E

### FGH

AB

C

D

E

## FGH Date: 2026-09-17

# Title: 2.4 GHz LoRa or FLRC card, same hardware

## File: e28-2g4m27s-rev-a.kicad_sch

PROBE 1 | TP5 RESET_N
VCC 1 | GND 2 | MISO_TX 3 | MOSI_RX 4
SCK_RTSN 5 | NSS_CTS 6 | GND 7 | RX_EN 8
TX_EN | 9 GND | 10 NRESET | 11 BUSY | 12 DIO1 | 13 DIO2 | 14 DIO3 | 15 GND | 16 U1

### E28-2G4M27S

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
10 10 J1

### TSW-110-07-G-S

PROBE 1 | TP8

### TX_EN

PROBE 1 | TP2
SPI_MOSI PROBE 1 | TP4 CS_N
PROBE 1 | TP6 BUSY
PROBE 1 | TP1

### SPI_SCK

PROBE 1 | TP3

### SPI_MISO

PROBE 1 | TP13 OUT_3V3
PROBE 1 | TP15

### EN_5V

PROBE 1 | TP19 MOD_GND
PROBE 1 | TP17
FB
PROBE 1 | TP16
SW
PROBE 1 | TP14 REG_GND
PROBE 1 | TP12

### AUX0

PROBE 1 | TP10

### IN_5V

PROBE 1 | TP20

### SW_GND

PROBE 1 | TP18 MOD_3V3
PROBE 1 | TP11 CLIP_GND
PROBE 1 | TP9 RX_EN

### H1 M3 alignment hole

FB 1

EN 2

VIN 3 | GND | 4
SW | 5 BST | 6 U2

### AP63203WU-7

1

1
2

2 R5
22
POWER 1 | #FLG03 POWER DECLARATION: RADIO_3V3

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
8 J2

### TSW-108-07-G-S

1

1
2

2 C6

100nF ⁺

1 | -

2 C5
220uF

1

1
2

2 C2
22uF

1

1
2

2 R4
10k

1

1
2

2 R2
10k

1

1
2

2 C8
22uF

1

1
2

2 C4
100nF
PROBE 1 | TP7

### IRQ

1

1
2

2 C1
22uF
POWER 1 | #FLG02 POWER DECLARATION: GND

1

1
2

2 R3
10k

1

1
2

2 R1
10k

1

1
2

2 C7
22uF

1

1
2

2 C3
22uF

1

1
2

2 L1

4.7uH

POWER 1 | #FLG01 POWER DECLARATION: SLOT_5V
RESET_N

TX_EN

IRQ

SLOT_5V

GND

RX_EN

GND

SLOT_5V

TX_EN

GND

SLOT_5V | BUSY SPI_MISO
GND | SPI_SCK

GND

GND

GND

RESET_N

BUSY

IRQ

AUX0

SPI_SCK

CS_N

SPI_MOSI

RADIO_3V3

# SLOT_5V GND

RADIO_3V3

RADIO_3V3 | GND

SW

BUSY SLOT_5V | SLOT_5V SW

GND

CS_N

GND

AUX0

IRQ

GND

GND

RADIO_3V3

SPI_SCK

RADIO_3V3

RADIO_3V3

SPI_MOSI TX_EN

GND

RADIO_3V3

RX_EN

TX_EN

RX_EN

SPI_MISO_SRC

RADIO_3V3

GND

GND

CS_N

RADIO_3V3

SPI_MISO

BST SW

GND

AUX0

SLOT_5V | GND

SPI_MOSI

BST | GND

GND

SPI_MISO

CS_N

RESET_N

SW | SLOT_5V RADIO_3V3 GND

RADIO_3V3

GND

SPI_MISO_SRC

SLOT_5V

RADIO_3V3

SLOT_5V

RX_EN

GND

RESET_N

RADIO_3V3 REV A LAYOUT REVIEW. NOT FOR FABRICATION.

## 2.4 GHz LoRa or FLRC card, same hardware

MISO: source -> 22R -> slot A7. Fit 0R option; scope/IBIS verify. Place at module output/socket, before shared bus. No long stubs. KEYED SLOT: H1 engages the carrier M3 x 25 post before electrical contact. All headers and passives factory fitted. No user soldering or antenna⁻selector rework. Power declarations describe power arriving through the slot and buck output after L1. Layout authorized; no fabrication release. See DESIGN_REVIEW.md.

ASSEMBLY VARIANT: IPEX ONLY. Selector MUST match manual section 9.2 right image. MCP23S17 controls TX_EN/RX_EN before RF commands. No automatic RX/TX modes. Buck PCB layout must follow figure 25, 2 oz copper on both layers.

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
