the-Drunken-coder/dual-band-radio-lab/hardware/renders/carrier-rev-a-3d.png

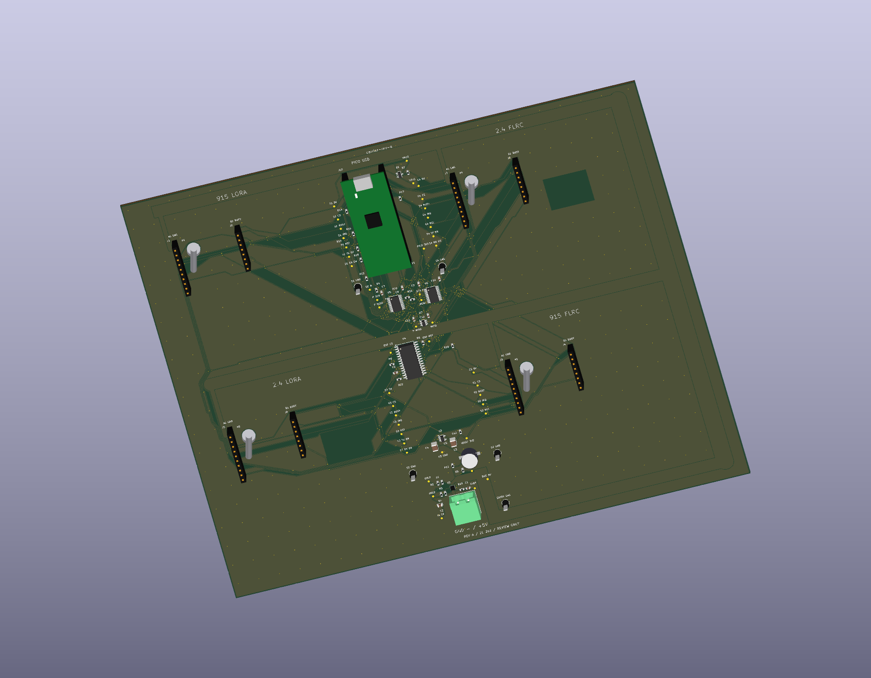
hardware/renders/carrier-rev-a-3d.png
