the-Drunken-coder/dual-band-radio-lab/hardware/renders/carrier-rev-a-bottom-3d.png

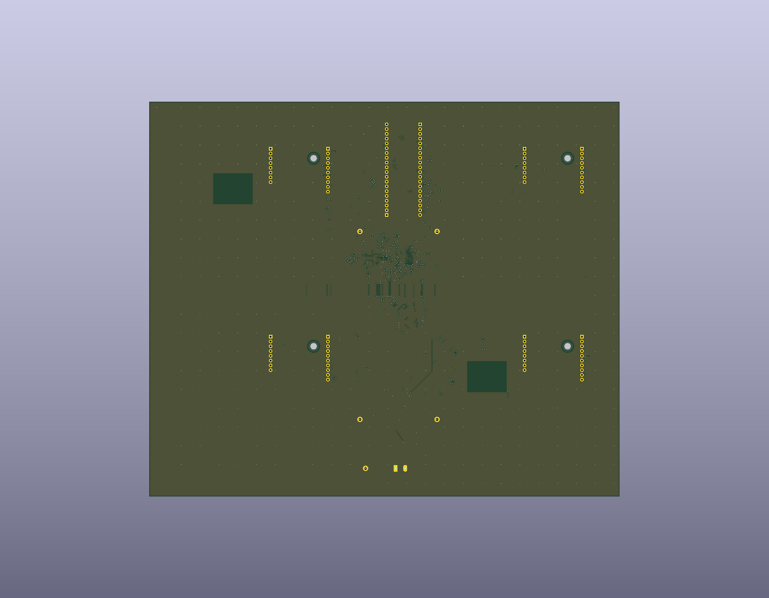
hardware/renders/carrier-rev-a-bottom-3d.png
