the-Drunken-coder/dual-band-radio-lab/hardware/renders/core2021-hf-m-rev-a-3d.png

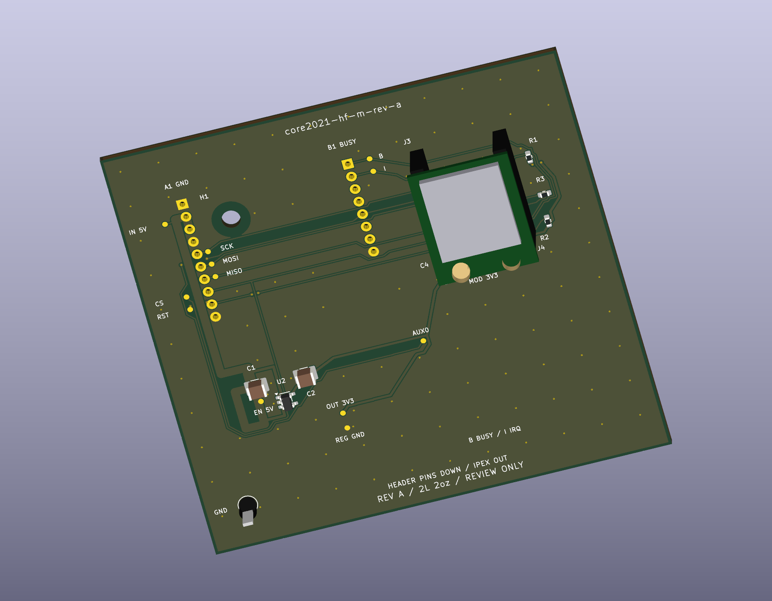
hardware/renders/core2021-hf-m-rev-a-3d.png
