the-Drunken-coder/dual-band-radio-lab/hardware/renders/e22-900m30s-rev-a-3d.png

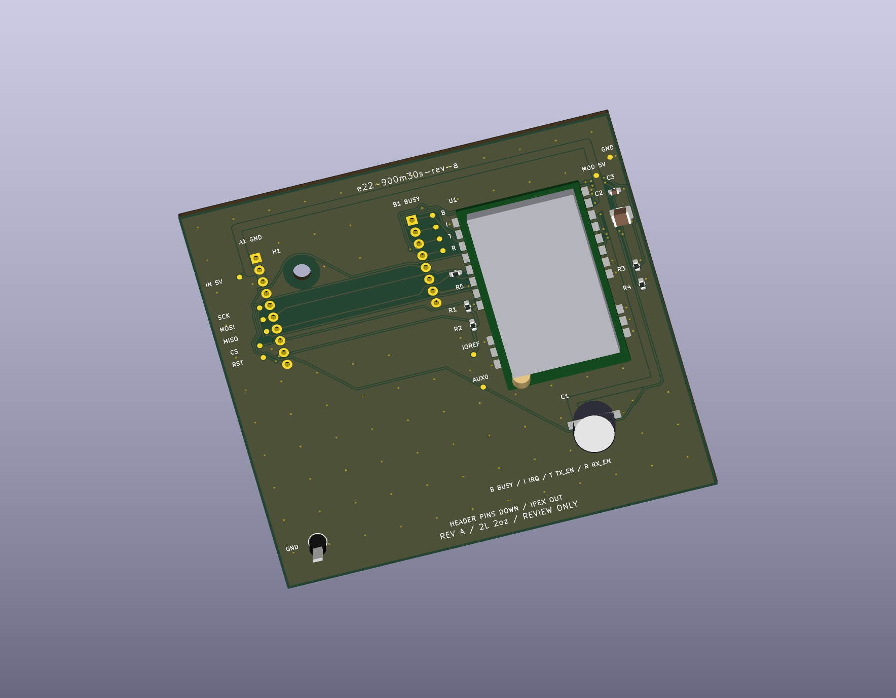
hardware/renders/e22-900m30s-rev-a-3d.png
