the-Drunken-coder/dual-band-radio-lab/hardware/renders/e28-2g4m27s-rev-a-3d.png

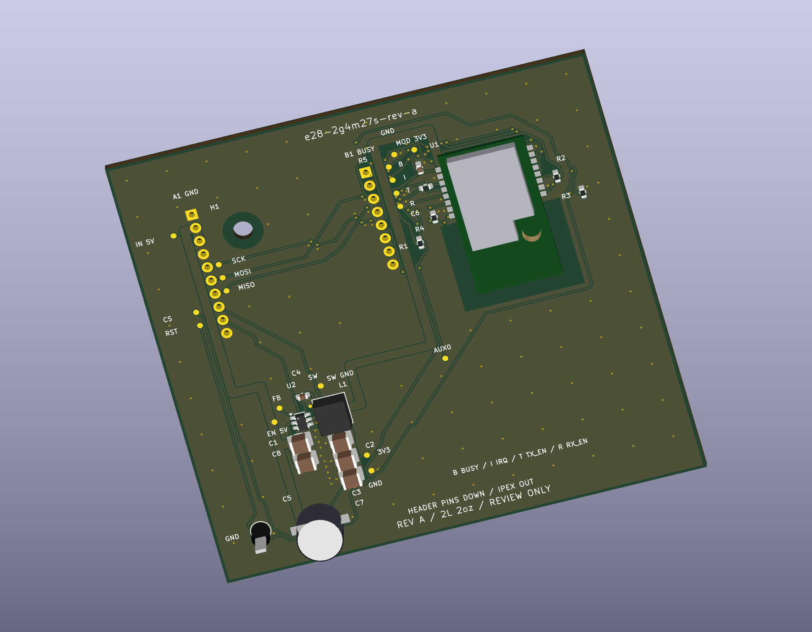
hardware/renders/e28-2g4m27s-rev-a-3d.png
