the-Drunken-coder/dual-band-radio-lab/hardware/sources/jlc-c411294-photo.jpg

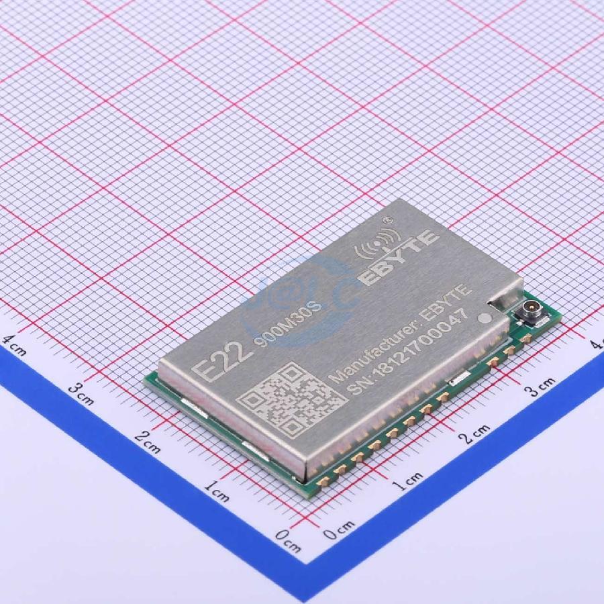
hardware/sources/jlc-c411294-photo.jpg
