the-Drunken-coder/dual-band-radio-lab/prototype/dual-lr2021-usb-carrier/extra/references/controller-power/extracted/ap7361c-pin-assignments.png

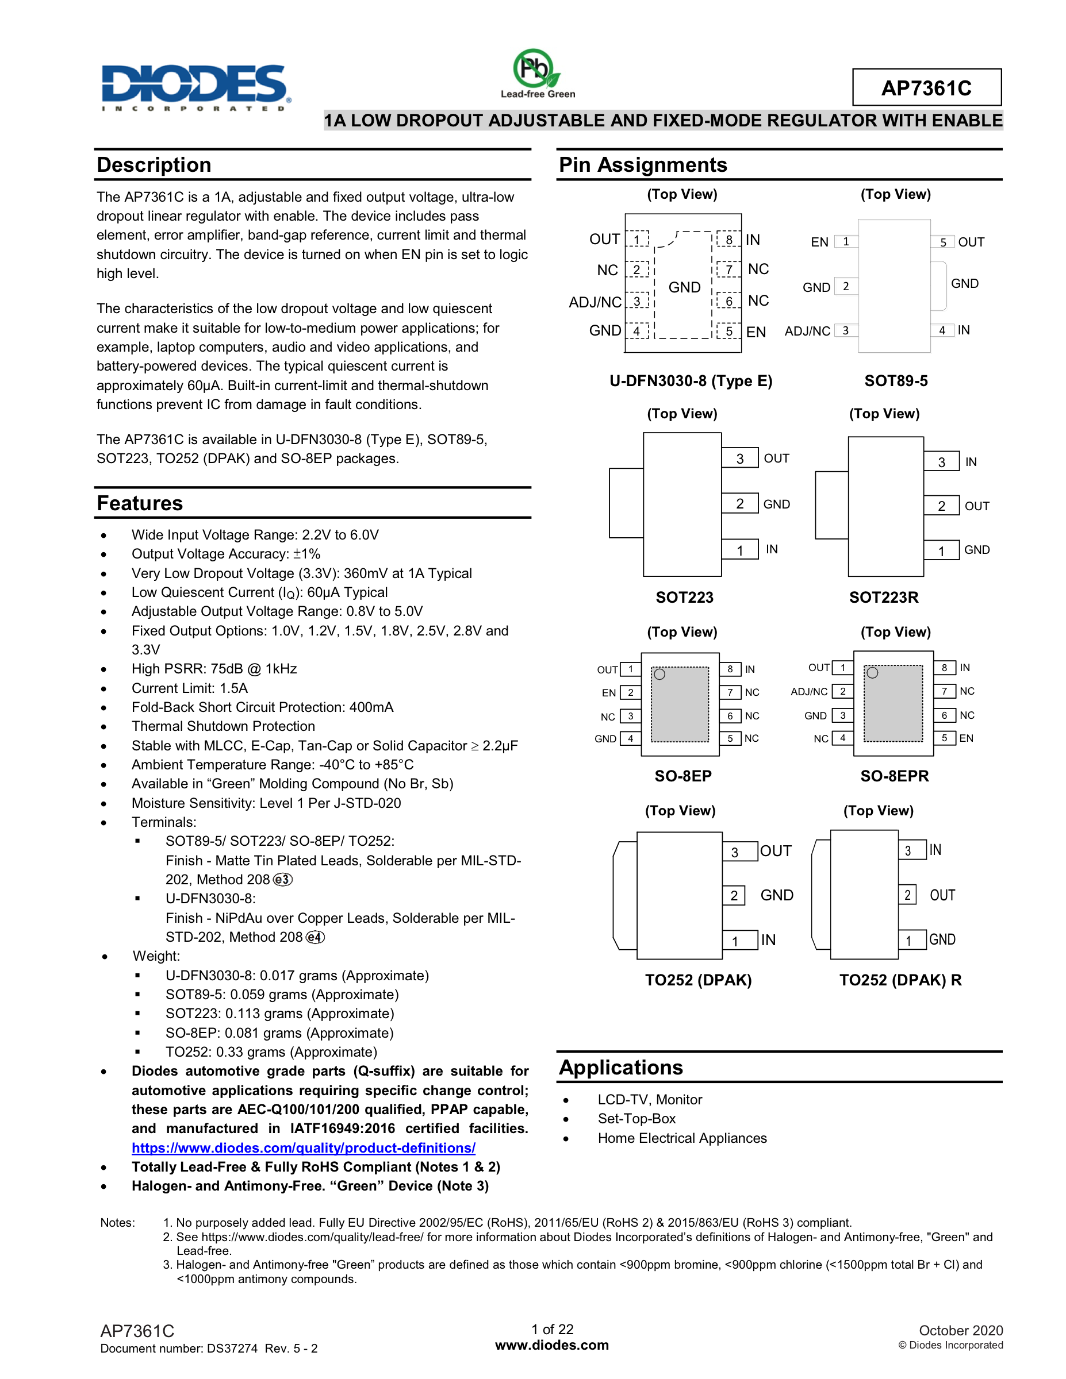
prototype/dual-lr2021-usb-carrier/extra/references/controller-power/extracted/ap7361c-pin-assignments.png
