the-Drunken-coder/dual-band-radio-lab/prototype/dual-lr2021-usb-carrier/extra/references/controller-power/extracted/pinout.png

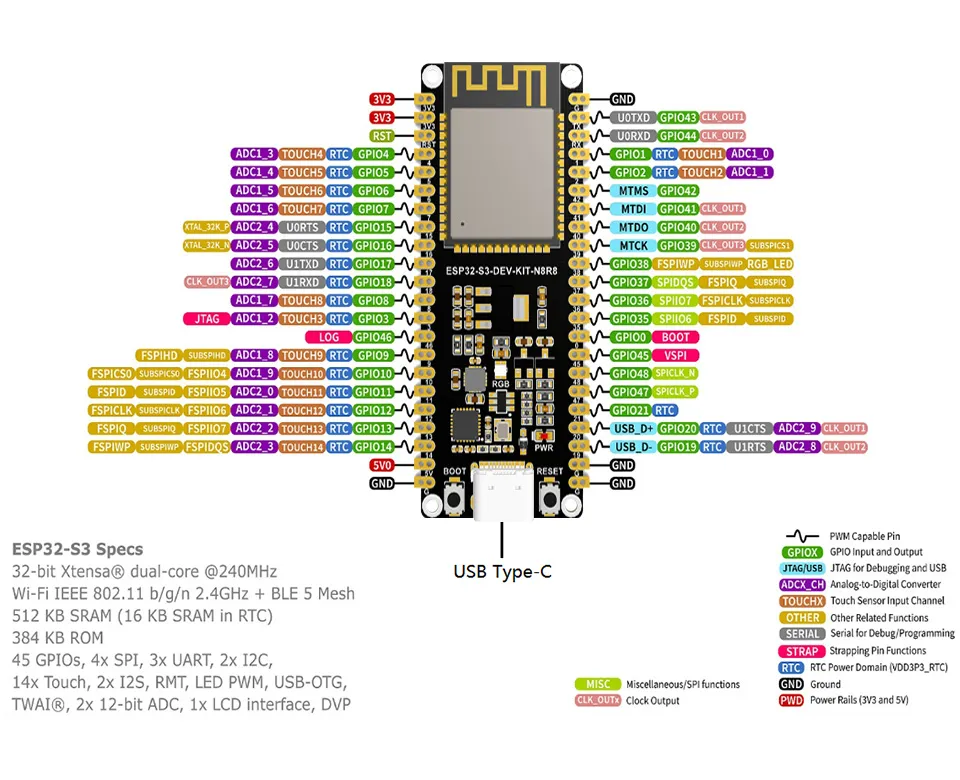
prototype/dual-lr2021-usb-carrier/extra/references/controller-power/extracted/pinout.png
