the-Drunken-coder/dual-band-radio-lab/prototype/dual-lr2021-usb-carrier/extra/references/radio/core2021-hf-m-3.jpg

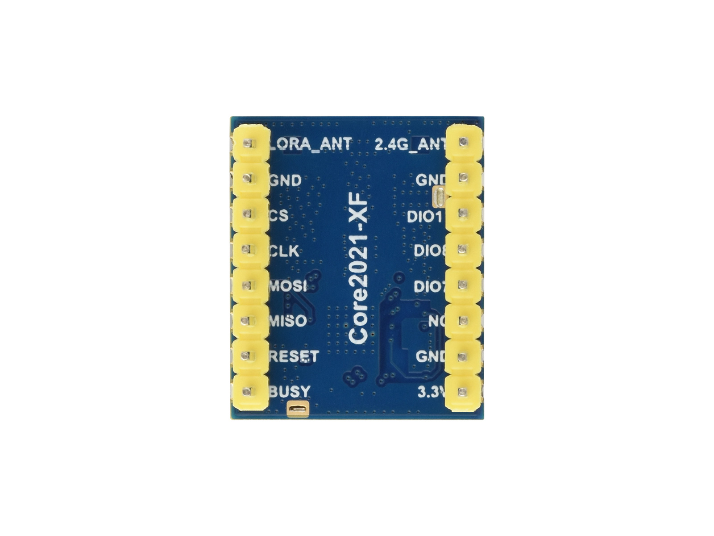
prototype/dual-lr2021-usb-carrier/extra/references/radio/core2021-hf-m-3.jpg
