the-Drunken-coder/dual-band-radio-lab/prototype/dual-lr2021-usb-carrier/extra/references/radio/Core2021-HF-Schematics-2.png

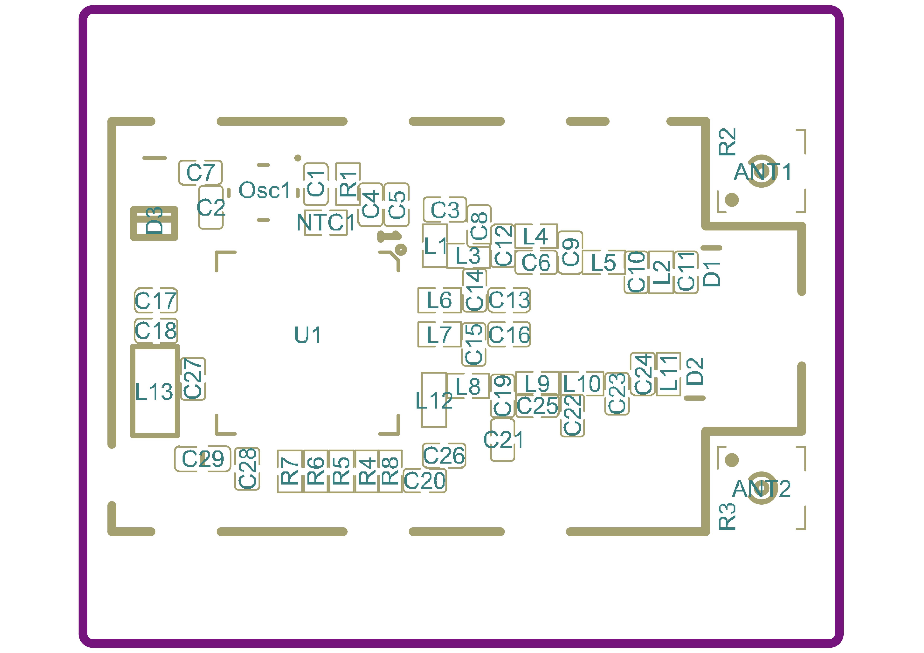
prototype/dual-lr2021-usb-carrier/extra/references/radio/Core2021-HF-Schematics-2.png
