the-Drunken-coder/dual-band-radio-lab/prototype/dual-lr2021-usb-carrier/extra/references/radio/core2021-xf-2D-1.png

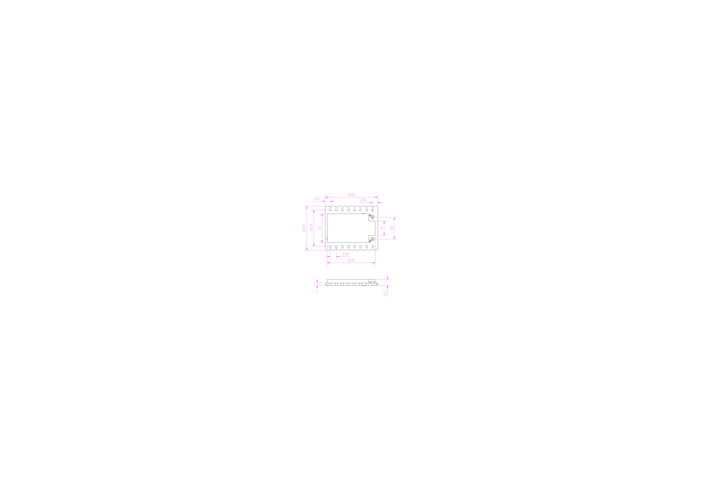
prototype/dual-lr2021-usb-carrier/extra/references/radio/core2021-xf-2D-1.png
