the-Drunken-coder/dual-band-radio-lab/prototype/dual-lr2021-usb-carrier/extra/references/radio/dimensions.png

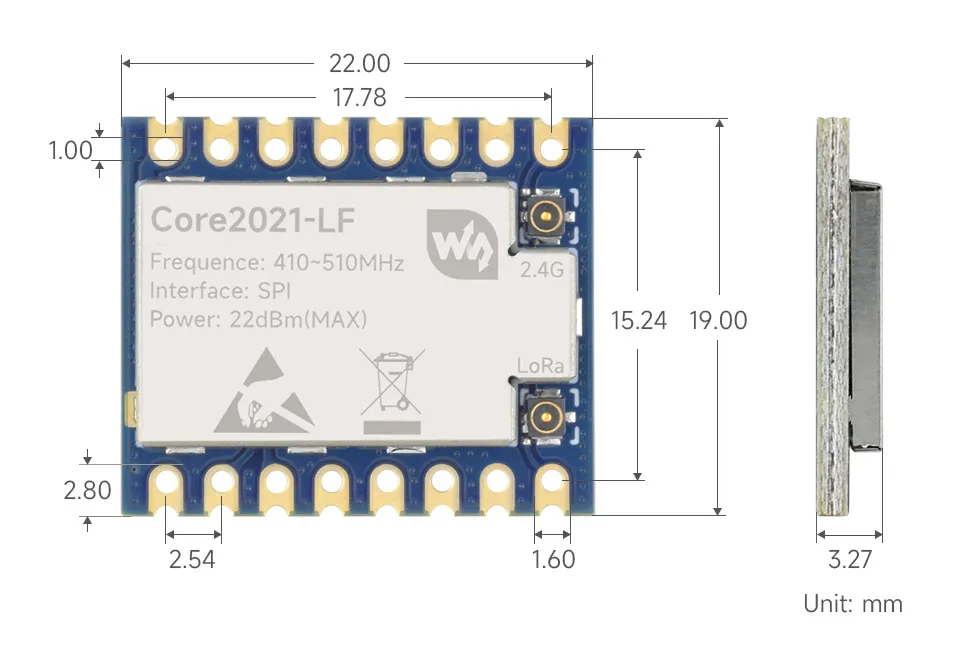
prototype/dual-lr2021-usb-carrier/extra/references/radio/dimensions.png
