the-Drunken-coder/dual-band-radio-lab/prototype/dual-lr2021-usb-carrier/extra/references/radio/drawing-detail.png

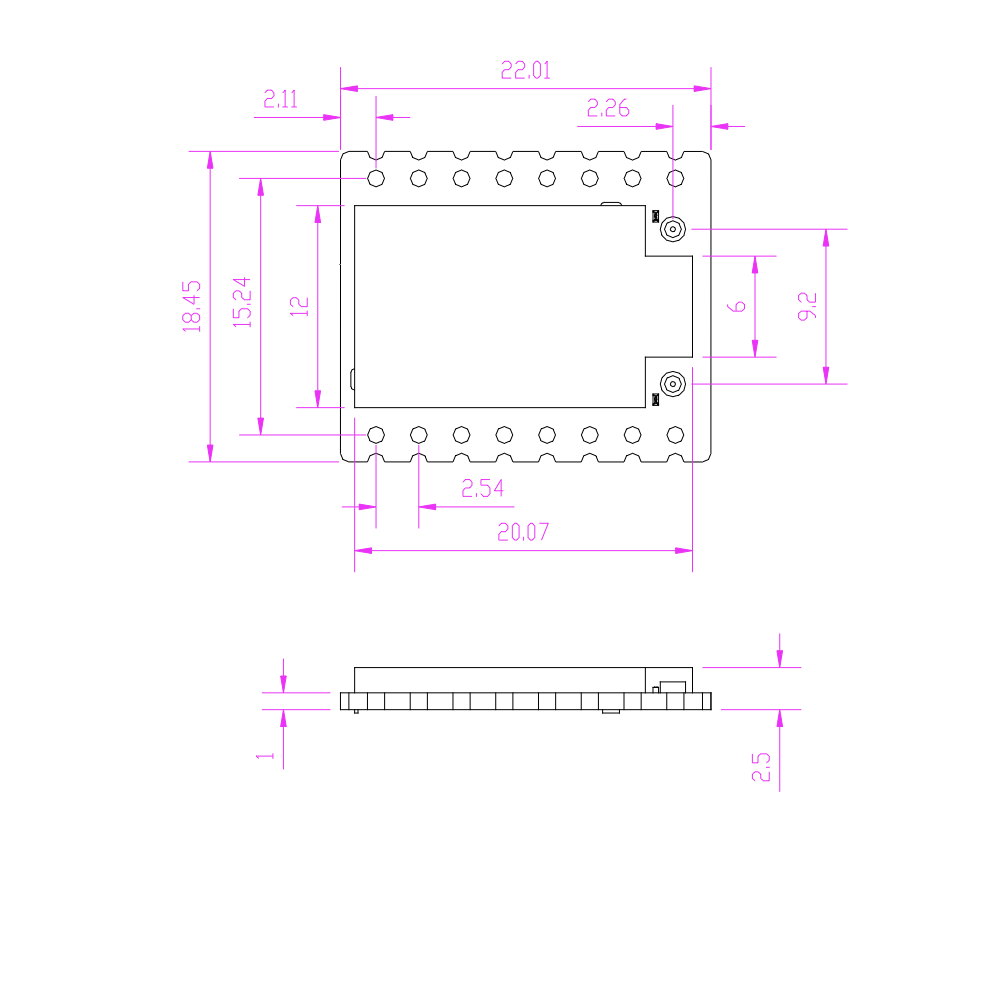
prototype/dual-lr2021-usb-carrier/extra/references/radio/drawing-detail.png
