the-Drunken-coder/dual-band-radio-lab/prototype/dual-lr2021-usb-carrier/extra/references/radio/product-photo.png

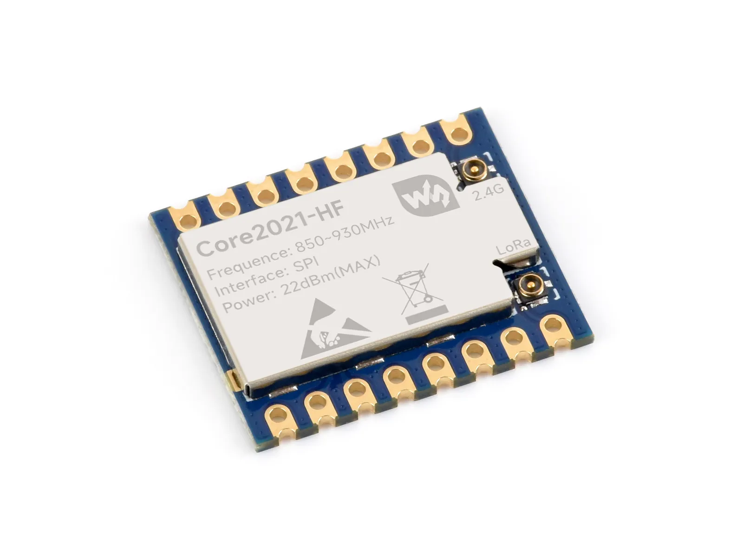
prototype/dual-lr2021-usb-carrier/extra/references/radio/product-photo.png
