the-Drunken-coder/dual-band-radio-lab/prototype/dual-lr2021-usb-carrier/extra/references/radio/ssw_th.png

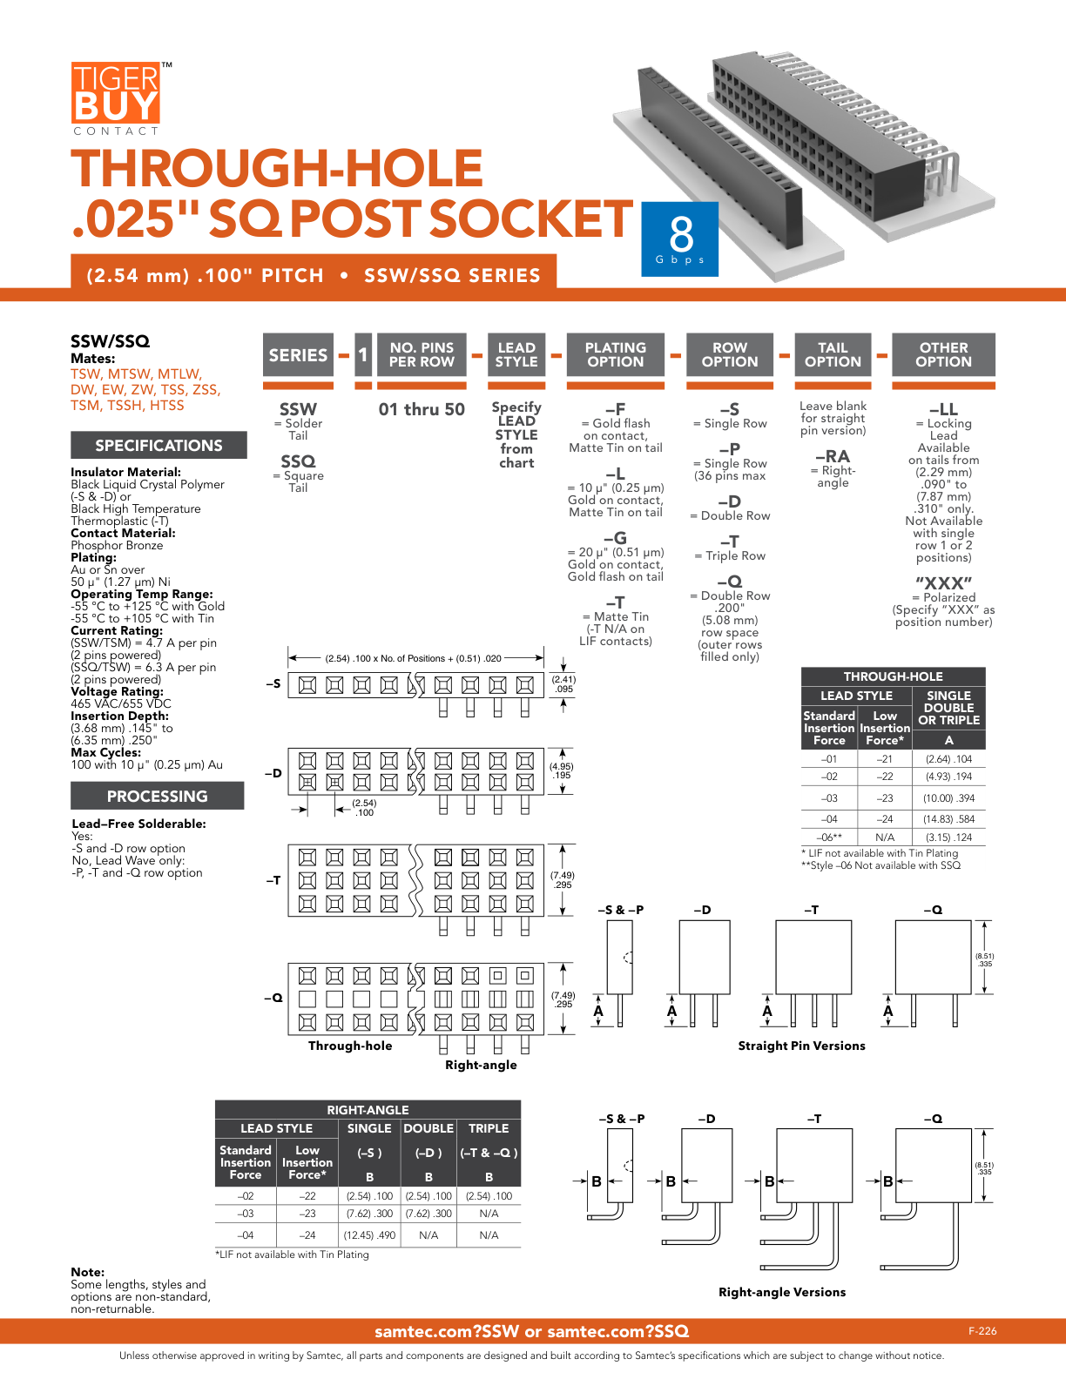
prototype/dual-lr2021-usb-carrier/extra/references/radio/ssw_th.png
