the-Drunken-coder/dual-band-radio-lab/research/multiband/2026-10-28/radio-range-rate-comparison.png

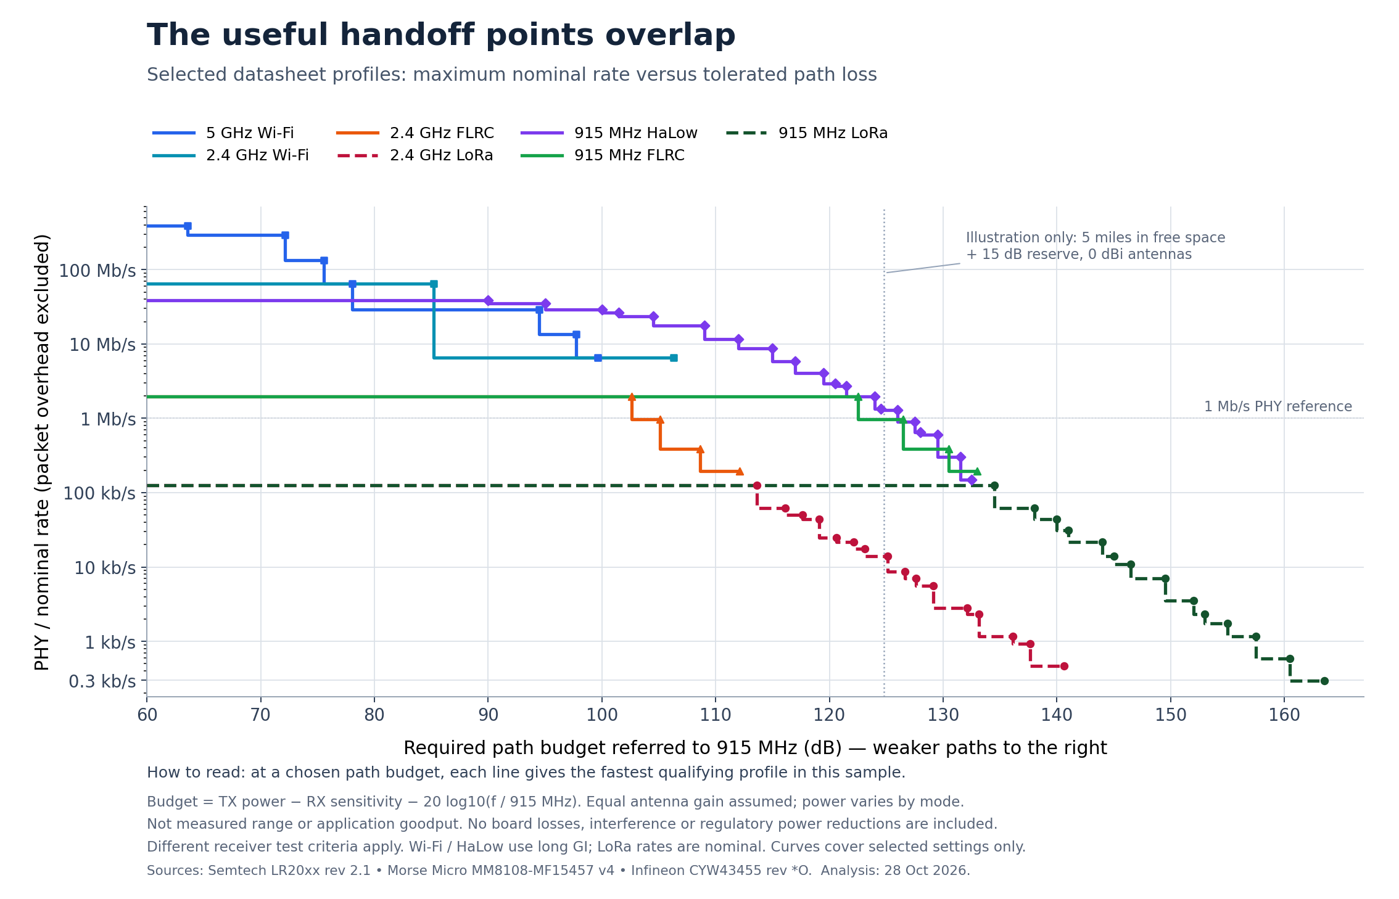
research/multiband/2026-10-28/radio-range-rate-comparison.png
