the-Drunken-coder/dual-band-radio-lab/hardware/adapters/e22-900m30s-rev-a/BOM.csv

reference | value | mpn | supplier | quantity | purpose | assembly | footprint | source
J1 | TSW-110-07-G-S | TSW-110-07-G-S |  | 1 | Slot A | factory | RadioLab:TSW_1x10 | Samtec tsw/ssq-drawing.pdf and footprint.pdf
J2 | TSW-108-07-G-S | TSW-108-07-G-S |  | 1 | Slot B | factory | RadioLab:TSW_1x8 | Samtec tsw/ssq-drawing.pdf and footprint.pdf
U1 | E22-900M30S | E22-900M30S | C411294 | 1 | 915 MHz LoRa | factory | RadioLab:E22_900M30S | E22-M manual section 3.3, PDF pages 10-11
C1 | 220uF | EEEFK1A221P |  | 1 | Local TX transient reservoir; 10 V polarized | factory | RadioLab:Panasonic_FK_E_8x6.2 | Panasonic; 220 uF 10 V 20%; panasonic-fk.pdf
C2 | 22uF | C3225X7R1E226M250AB |  | 1 | Local supply decoupling | factory | Capacitor_SMD:C_1210_3225Metric | TDK; 22 uF 25 V X7R 20%; sources/online-evidence.md
C3 | 100nF | GRM188R71H104KA93D |  | 1 | Local ceramic decoupling | factory | Capacitor_SMD:C_0603_1608Metric | Murata; 100 nF 50 V X7R 10%
R5 | 22 | RC0603FR-0722RL |  | 1 | Source-series termination; place immediately at U1 MISO pad 16 before any bus branch; no long stubs | Initially 22 ohm; configurable 0 ohm alternate RC0603JR-070RL in same footprint; verify by oscilloscope/IBIS during bring-up; DNP opens signal | Resistor_SMD:R_0603_1608Metric | Yageo RC0603; 22 ohm 1% 0.1 W; yageo-rc.pdf
R1 | 10k | RC0603FR-0710KL |  | 1 | Default deselected, radio-domain pull-up | factory | Resistor_SMD:R_0603_1608Metric | Yageo RC0603; 1% 0.1 W
R2 | 10k | RC0603FR-0710KL |  | 1 | Default released; PA/LNA stay disabled and CS stays high until host initializes | factory | Resistor_SMD:R_0603_1608Metric | Yageo RC0603; 1% 0.1 W
R3 | 10k | RC0603FR-0710KL |  | 1 | Default PA/LNA inactive | factory | Resistor_SMD:R_0603_1608Metric | Yageo RC0603; 1% 0.1 W
R4 | 10k | RC0603FR-0710KL |  | 1 | Default PA/LNA inactive | factory | Resistor_SMD:R_0603_1608Metric | Yageo RC0603; 1% 0.1 W
TP11 | CLIP_GND | 5011 |  | 1 | Accessible ground clip | Factory fitted | TestPoint:TestPoint_Keystone_5010-5014_Multipurpose | Keystone 5011 drawing and manufacturer category 748
