the-Drunken-coder/dual-band-radio-lab/prototype/dual-lr2021-usb-carrier/boards/dual-radio-carrier/bom.csv

Reference | Quantity | Value | Manufacturer part number | Footprint | Assembly
J1 | 1 | SSW-122-01-G-S | SSW-122-01-G-S | Socket_1x22_P2.54_USB_Top | Solder to carrier
J2 | 1 | SSW-122-01-G-S | SSW-122-01-G-S | Socket_1x22_P2.54_USB_Top | Solder to carrier
J3 | 1 | SSW-108-01-G-S | SSW-108-01-G-S | Socket_1x08_P2.54_Horizontal_SolidGND2 | Solder to carrier
J4 | 1 | SSW-108-01-G-S | SSW-108-01-G-S | Socket_1x08_P2.54_Horizontal | Solder to carrier
J5 | 1 | SSW-108-01-G-S | SSW-108-01-G-S | Socket_1x08_P2.54_Horizontal | Solder to carrier
J6 | 1 | SSW-108-01-G-S | SSW-108-01-G-S | Socket_1x08_P2.54_Horizontal | Solder to carrier
R1 | 1 | 10k | RC0805FR-0710KL | R_0805 | Solder to carrier
R2 | 1 | 10k | RC0805FR-0710KL | R_0805 | Solder to carrier
R3 | 1 | 10k | RC0805FR-0710KL | R_0805 | Solder to carrier
R4 | 1 | 10k | RC0805FR-0710KL | R_0805 | Solder to carrier
R5 | 1 | 33R | RC0805FR-0733RL | R_0805 | Solder to carrier
R6 | 1 | 33R | RC0805FR-0733RL | R_0805 | Solder to carrier
C1 | 1 | 10uF 25V X7R | C1206C106K3RACTU | C_1206 | Solder to carrier
C2 | 1 | 10uF 25V X7R | C1206C106K3RACTU | C_1206 | Solder to carrier
C3 | 1 | 10uF 25V X7R | C1206C106K3RACTU | C_1206 | Solder to carrier
C4 | 1 | 100nF 50V X7R | C0805C104K5RACTU | C_0805 | Solder to carrier
C5 | 1 | 10uF 25V X7R | C1206C106K3RACTU | C_1206 | Solder to carrier
C6 | 1 | 100nF 50V X7R | C0805C104K5RACTU | C_0805 | Solder to carrier
U1 | 1 | TLV1117LV33DCYR | TLV1117LV33DCYR | SOT223_TabPin2 | Solder to carrier
MODULE_MCU | 1 | ESP32-S3 controller | ESP32-S3-DEV-KIT-N8R8-M | J1 + J2 | Plug in after soldering
MODULE_A / MODULE_B | 2 | LR2021 dual-band radio | Core2021-HF-M | J3+J4 / J5+J6 | Plug in after soldering
