the-Drunken-coder/dual-band-radio-lab/prototype/dual-lr2021-usb-carrier/mfg/dual-radio-carrier-rev-a-prototype/radio-socket-map.csv

Carrier contact | Radio | Module pin | Function | Net
J3.1 | A | 8 | 3V3 | +3V3_RADIO
J3.2 | A | 7 | GND | GND
J3.3 | A | 6 | NC | NC
J3.4 | A | 5 | DIO7 | NC
J3.5 | A | 4 | DIO8 | NC
J3.6 | A | 3 | DIO11 | RADIO_A_DIO11
J3.7 | A | 2 | GND | GND
J3.8 | A | 1 | 2.4G_ANT | NC
J4.1 | A | 9 | BUSY | RADIO_A_BUSY
J4.2 | A | 10 | RESET | RADIO_A_RESET_N
J4.3 | A | 11 | MISO | SPI_MISO
J4.4 | A | 12 | MOSI | SPI_MOSI
J4.5 | A | 13 | SCK | SPI_SCK
J4.6 | A | 14 | NSS | RADIO_A_CS_N
J4.7 | A | 15 | GND | GND
J4.8 | A | 16 | LoRa_ANT | NC
J5.1 | B | 8 | 3V3 | +3V3_RADIO
J5.2 | B | 7 | GND | GND
J5.3 | B | 6 | NC | NC
J5.4 | B | 5 | DIO7 | NC
J5.5 | B | 4 | DIO8 | NC
J5.6 | B | 3 | DIO11 | RADIO_B_DIO11
J5.7 | B | 2 | GND | GND
J5.8 | B | 1 | 2.4G_ANT | NC
J6.1 | B | 9 | BUSY | RADIO_B_BUSY
J6.2 | B | 10 | RESET | RADIO_B_RESET_N
J6.3 | B | 11 | MISO | SPI_MISO
J6.4 | B | 12 | MOSI | SPI_MOSI
J6.5 | B | 13 | SCK | SPI_SCK
J6.6 | B | 14 | NSS | RADIO_B_CS_N
J6.7 | B | 15 | GND | GND
J6.8 | B | 16 | LoRa_ANT | NC
