the-Drunken-coder/dual-band-radio-lab/prototype/dual-lr2021-usb-carrier/extra/references/controller-power/sources/controller-3d.step

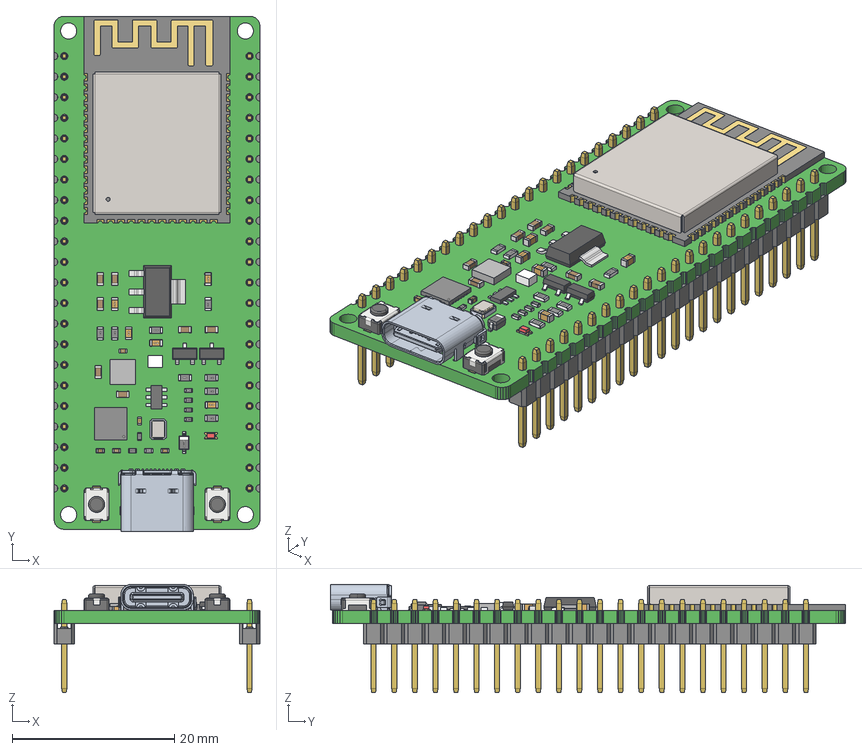
[picture p30: CAD file, 2026-10-24]
prototype/dual-lr2021-usb-carrier/extra/references/controller-power/sources/controller-3d.step
25.4 x 63.6 x 13.3 mm
BOARD
3_1_A x 5
3_1_2_A x 5
5_1_2_A x 7
_7_AF0 x 7
USER_LIBRARY-LED_0603_R_-145436
USER_LIBRARY-LED_0603_R_PAD004
USER_LIBRARY-LED_0603_R_FILLET
USER_LIBRARY-LED_0603_R_-147791
USER_LIBRARY-LED_0603_R_PAD
C0201_20210301_STEP_C0201_20210 x 14
L0201_20210301_STEP_L0201_20210 x 3
C0402_20210301_STEP_C0402_20210
R0201_20210301_STEP_R0201_202_1 x 8
R0201_20210301_STEP_R0201_202_2 x 8
R0201_20210301_STEP_R0201_202_3 x 8
TRACE_1_SUBMODEL-MINI-ANT-TYPEB
DFN1006_STEP_DFN1006_STEP_SUBMO
SOP8_REV1_20210308_STEP_SOP8_RE
XTAL3225_20210301_STEP_XTAL32_1
XTAL3225_20210301_STEP_XTAL32_2
XTAL3225_20210301_STEP_XTAL32_3
XTAL3225_20210301_STEP_XTAL32_4
XTAL3225_20210301_STEP_XTAL32_5
ESP32-S3_20210301_STEP_ESP32-_1
ESP32-S3_20210301_STEP_ESP32-_2
UID__4-128_DESIGNROOTMODEL_PCB_
UID__4-129_DESIGNROOTMODEL_PCB_
UID__4-130_DESIGNROOTMODEL_PCB_
UID__4-149_DESIGNROOTMODEL_PCB_
UID__4-150_DESIGNROOTMODEL_PCB_
UID__4-151_DESIGNROOTMODEL_PCB_
UID__4-167_DESIGNROOTMODEL_PCB_
UID__4-168_DESIGNROOTMODEL_PCB_
UID__4-169_DESIGNROOTMODEL_PCB_
UID__1-279_DESIGNROOTMODEL_PCB_
UID__1-280_DESIGNROOTMODEL_PCB_
UID__1-292_DESIGNROOTMODEL_PCB_
UID__1-298_DESIGNROOTMODEL_PCB_
UID__1-299_DESIGNROOTMODEL_PCB_
UID__1-300_DESIGNROOTMODEL_PCB_
UID__1-301_DESIGNROOTMODEL_PCB_
UID__1-304_DESIGNROOTMODEL_PCB_
UID__1-305_DESIGNROOTMODEL_PCB_
UID__1-308_DESIGNROOTMODEL_PCB_
UID__1-310_DESIGNROOTMODEL_PCB_
UID__1-311_DESIGNROOTMODEL_PCB_
UID__1-325_DESIGNROOTMODEL_PCB_
UID__1-334_DESIGNROOTMODEL_PCB_
UID__1-338_DESIGNROOTMODEL_PCB_
UID__1-339_DESIGNROOTMODEL_PCB_
UID__1-340_DESIGNROOTMODEL_PCB_
UID__1-343_DESIGNROOTMODEL_PCB_
UID__1-344_DESIGNROOTMODEL_PCB_
UID__1-345_DESIGNROOTMODEL_PCB_
UID__1-352_DESIGNROOTMODEL_PCB_
UID__1-354_DESIGNROOTMODEL_PCB_
UID__1-355_DESIGNROOTMODEL_PCB_
UID__1-357_DESIGNROOTMODEL_PCB_
UID__1-358_DESIGNROOTMODEL_PCB_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
