the-Drunken-coder/dual-band-radio-lab/prototype/dual-lr2021-usb-carrier/extra/references/controller-power/sources/controller-dimensions.dxf

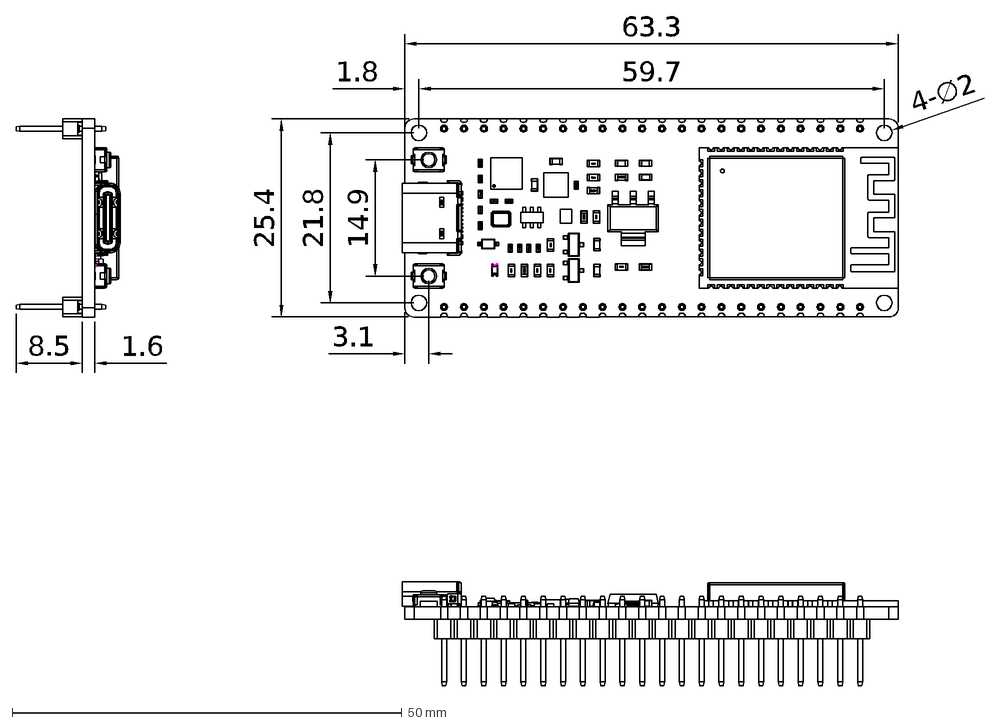
[picture p31: CAD file, 2026-10-24]
prototype/dual-lr2021-usb-carrier/extra/references/controller-power/sources/controller-dimensions.dxf
63.3
21.8
25.4
14.9
4-∅2
59.7
1.8
1.6
8.5
3.1
