the-Drunken-coder/dual-band-radio-lab/hardware/adapters/core2021-hf-m-rev-a/fabrication/DO_NOT_FABRICATE.md

# No fabrication release

PCB layout review only. No Gerbers, drills, placement files or ordering release. See `hardware/DESIGN_REVIEW.md`.
