the-Drunken-coder/dual-band-radio-lab/hardware/renders/rev-a-assembled-3d.png

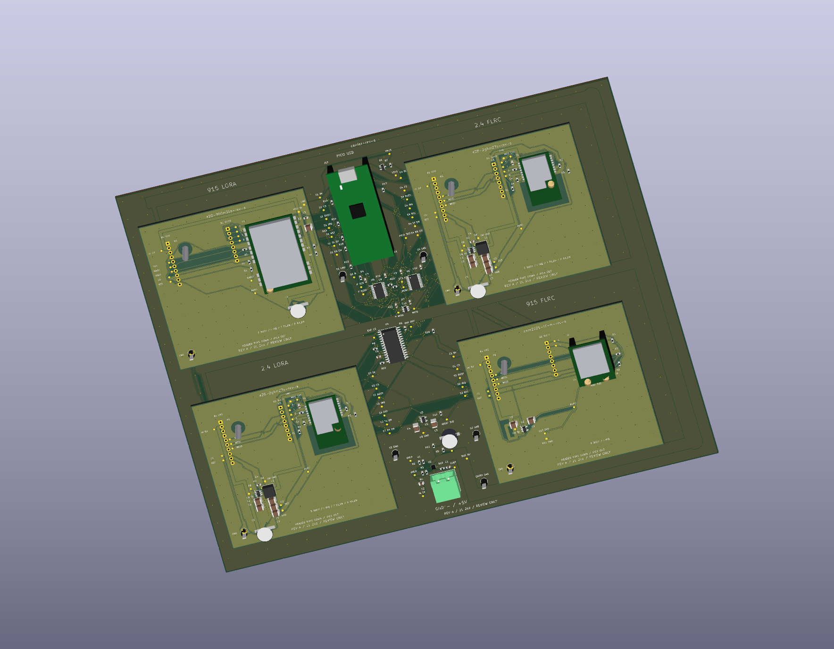
hardware/renders/rev-a-assembled-3d.png
