the-Drunken-coder/dual-band-radio-lab/(list of files, drawings)

Other design files:
hardware/layout/core2021-hf-m-rev-a.dsn
