the-Drunken-coder/dual-band-radio-lab/prototype/dual-lr2021-usb-carrier/boards/dual-radio-carrier/dual-radio-carrier.kicad_pcb

## KiCad design prototype/dual-lr2021-usb-carrier/boards/dual-radio-carrier/dual-radio-carrier.kicad_pcb (2026-10-24)

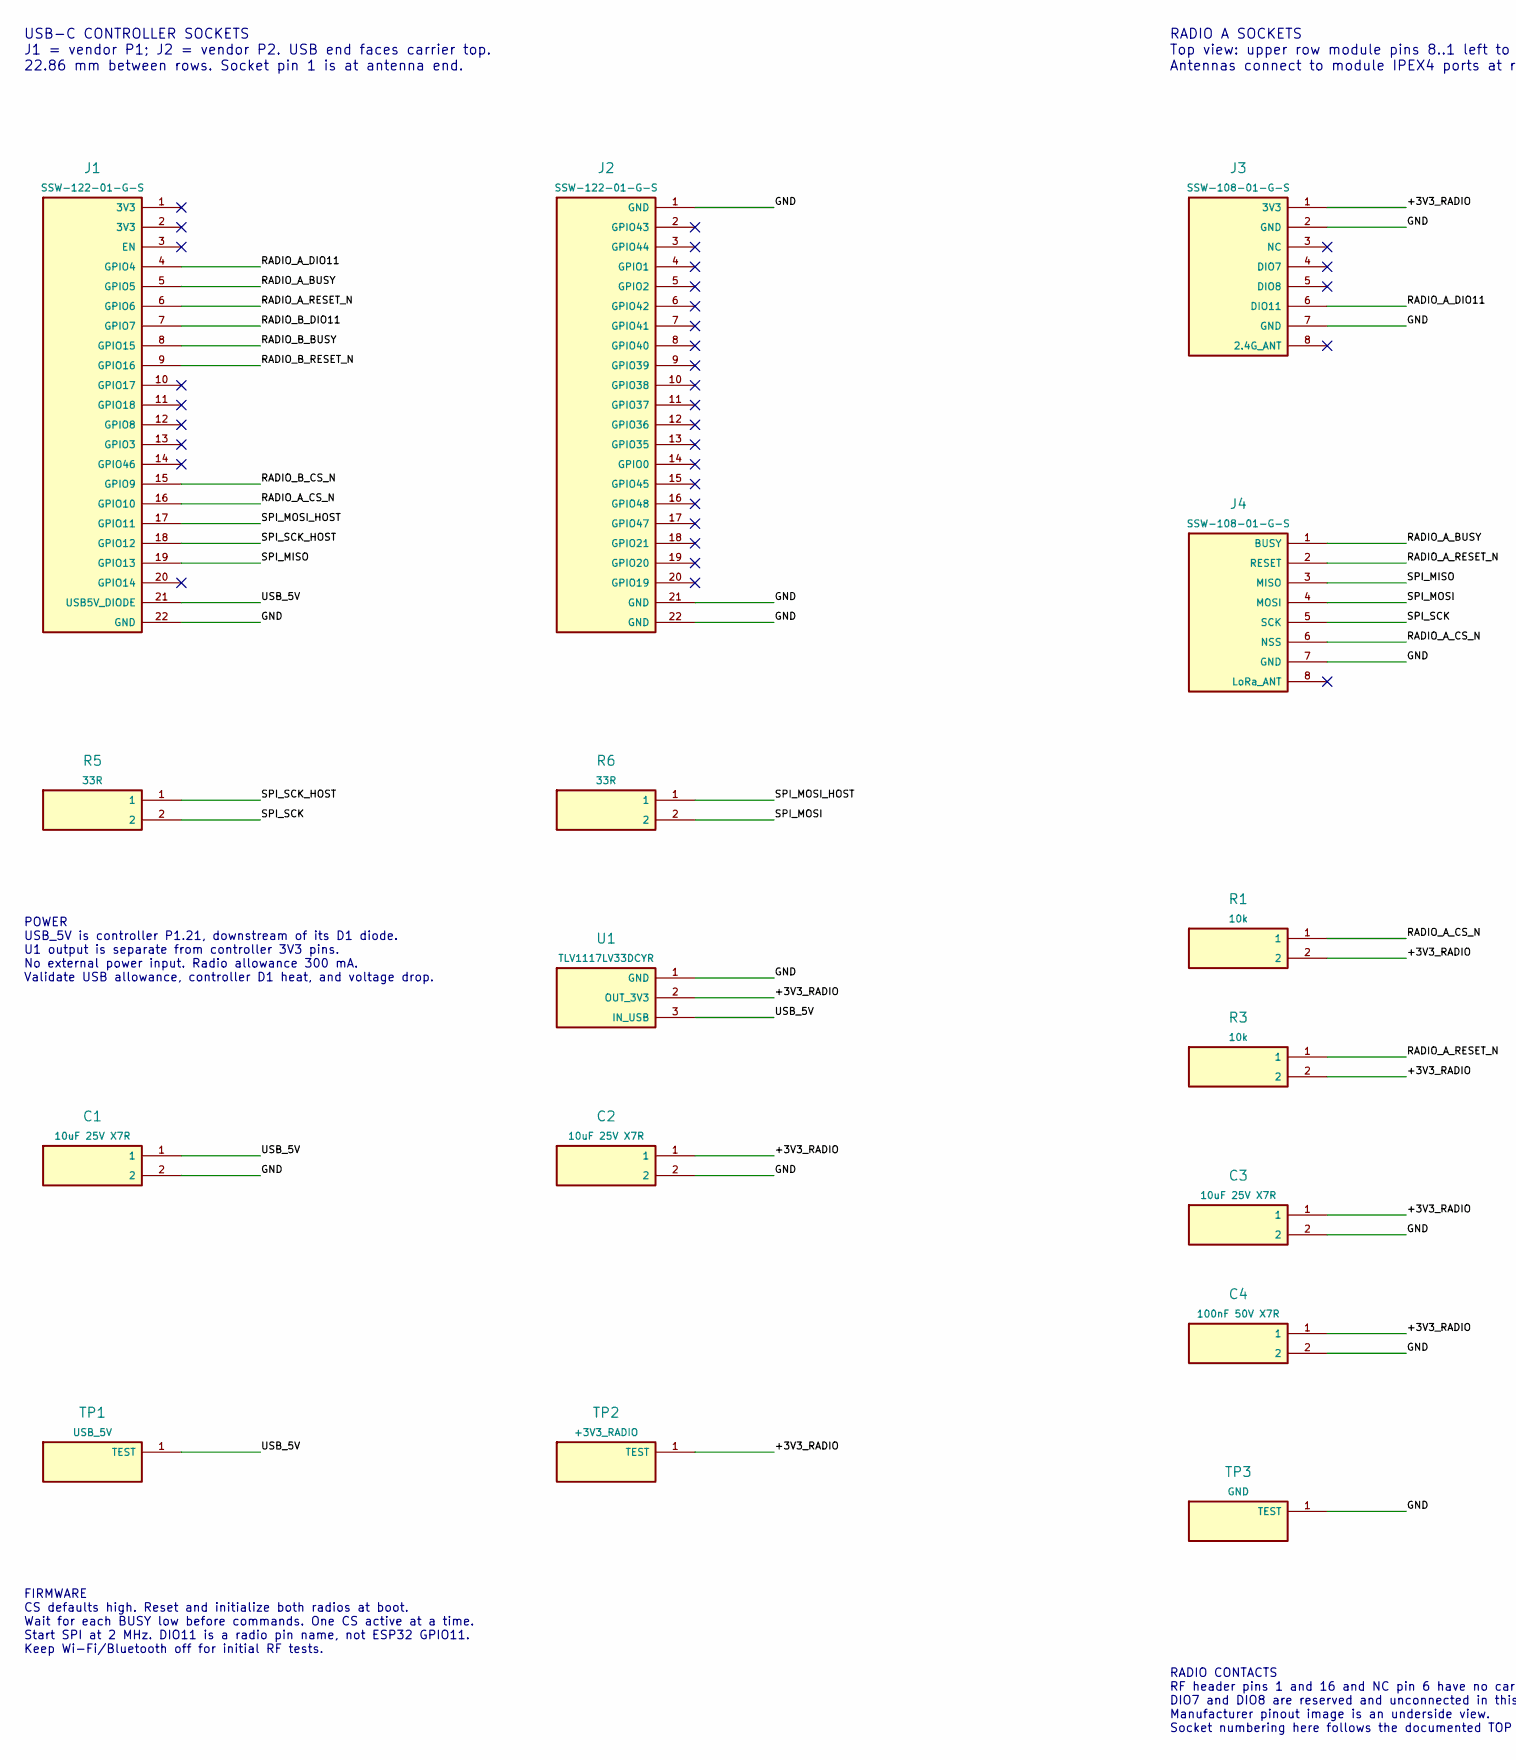
[picture p33: schematic dual-radio-carrier.kicad_sch, Dual LR2021 USB test carrier, part in row 1, column 1]

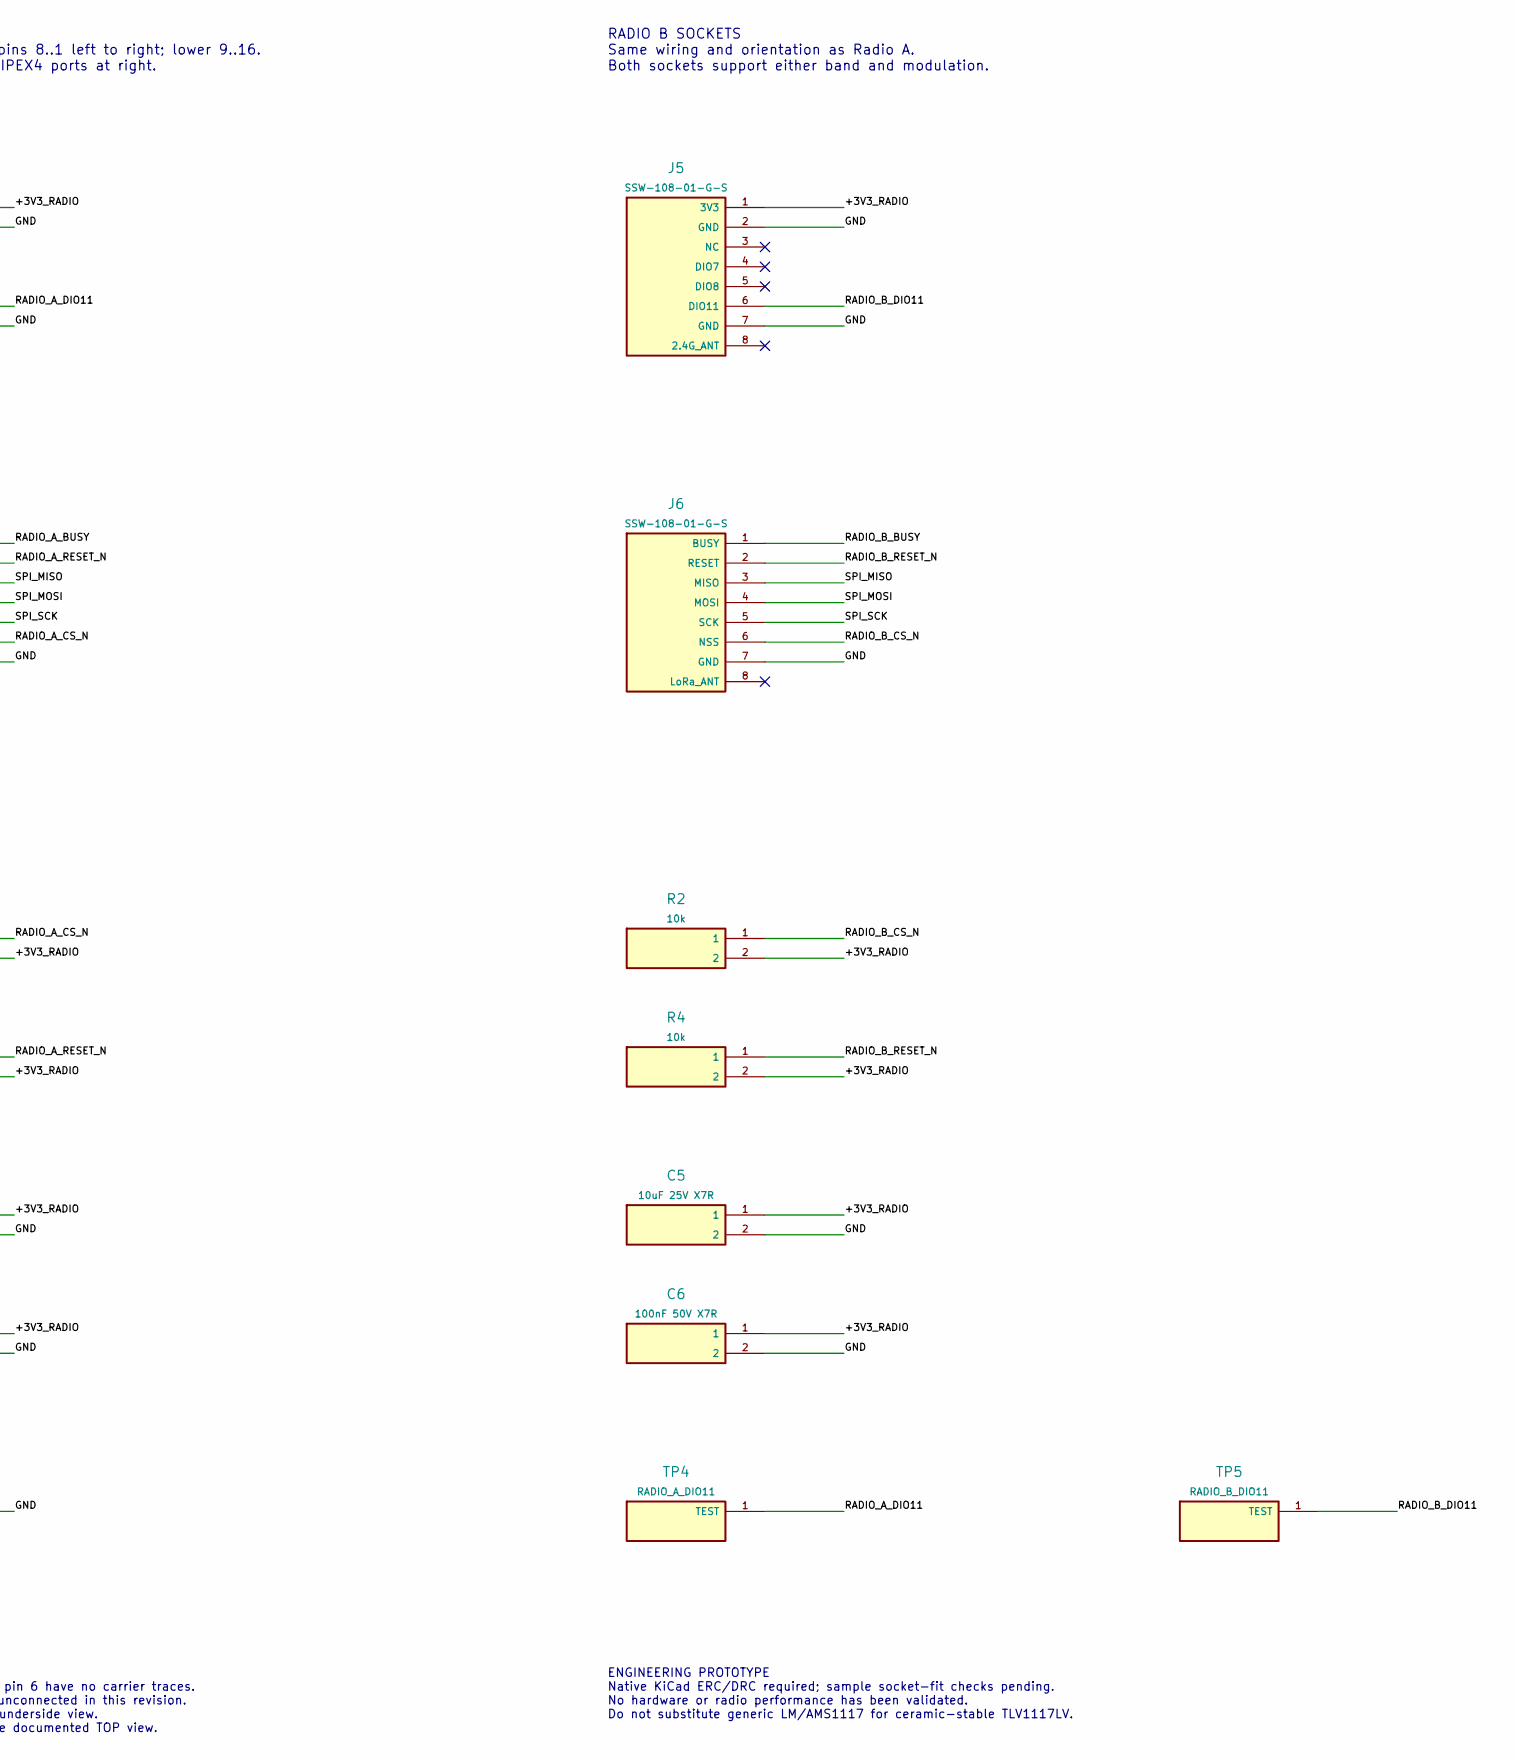
[picture p34: schematic dual-radio-carrier.kicad_sch, Dual LR2021 USB test carrier, part in row 1, column 2]

Parts:
C1, C2, C3, C5: 10uF 25V X7R; C_1206; MPN C1206C106K3RACTU
C4, C6: 100nF 50V X7R; C_0805; MPN C0805C104K5RACTU
J1, J2: SSW-122-01-G-S; Socket_1x22_P2.54_USB_Top; MPN SSW-122-01-G-S
J3: SSW-108-01-G-S; Socket_1x08_P2.54_Horizontal_SolidGND2; MPN SSW-108-01-G-S
J4, J5, J6: SSW-108-01-G-S; Socket_1x08_P2.54_Horizontal; MPN SSW-108-01-G-S
R1, R2, R3, R4: 10k; R_0805; MPN RC0805FR-0710KL
R5, R6: 33R; R_0805; MPN RC0805FR-0733RL
TP1: USB_5V; TestPoint_1.5mm; MPN PCB copper test pad
TP2: +3V3_RADIO; TestPoint_1.5mm; MPN PCB copper test pad
TP3: GND; TestPoint_1.5mm; MPN PCB copper test pad
TP4: RADIO_A_DIO11; TestPoint_1.5mm; MPN PCB copper test pad
TP5: RADIO_B_DIO11; TestPoint_1.5mm; MPN PCB copper test pad
U1: TLV1117LV33DCYR; SOT223_TabPin2; MPN TLV1117LV33DCYR

Connections:
/+3V3_RADIO: C2.1, C3.1, C4.1, C5.1, C6.1, J3.1 (3V3), J5.1 (3V3), R1.2, R2.2, R3.2, R4.2, TP2.1, U1.2 (OUT_3V3)
/GND: C1.2, C2.2, C3.2, C4.2, C5.2, C6.2, J1.22 (GND), J2.1 (GND), J2.21 (GND), J2.22 (GND), J3.2 (GND), J3.7 (GND), J4.7 (GND), J5.2 (GND), J5.7 (GND), J6.7 (GND), TP3.1, U1.1 (GND)
/RADIO_A_BUSY: J1.5 (GPIO5), J4.1 (BUSY)
/RADIO_A_CS_N: J1.16 (GPIO10), J4.6 (NSS), R1.1
/RADIO_A_DIO11: J1.4 (GPIO4), J3.6 (DIO11), TP4.1
/RADIO_A_RESET_N: J1.6 (GPIO6), J4.2 (RESET), R3.1
/RADIO_B_BUSY: J1.8 (GPIO15), J6.1 (BUSY)
/RADIO_B_CS_N: J1.15 (GPIO9), J6.6 (NSS), R2.1
/RADIO_B_DIO11: J1.7 (GPIO7), J5.6 (DIO11), TP5.1
/RADIO_B_RESET_N: J1.9 (GPIO16), J6.2 (RESET), R4.1
/SPI_MISO: J1.19 (GPIO13), J4.3 (MISO), J6.3 (MISO)
/SPI_MOSI: J4.4 (MOSI), J6.4 (MOSI), R6.2
/SPI_MOSI_HOST: J1.17 (GPIO11), R6.1
/SPI_SCK: J4.5 (SCK), J6.5 (SCK), R5.2
/SPI_SCK_HOST: J1.18 (GPIO12), R5.1
/USB_5V: C1.1, J1.21 (USB5V_DIODE), TP1.1, U1.3 (IN_USB)

Notes on the sheet:
USB-C CONTROLLER SOCKETS J1 = vendor P1; J2 = vendor P2. USB end faces carrier top. 22.86 mm between rows. Socket pin 1 is at antenna end.
RADIO A SOCKETS Top view: upper row module pins 8..1 left to right; lower 9..16. Antennas connect to module IPEX4 ports at right.
RADIO B SOCKETS Same wiring and orientation as Radio A. Both sockets support either band and modulation.
POWER USB_5V is controller P1.21, downstream of its D1 diode. U1 output is separate from controller 3V3 pins. No external power input. Radio allowance 300 mA. Validate USB allowance, controller D1 heat, and voltage drop.
FIRMWARE CS defaults high. Reset and initialize both radios at boot. Wait for each BUSY low before commands. One CS active at a time. Start SPI at 2 MHz. DIO11 is a radio pin name, not ESP32 GPIO11. Keep Wi-Fi/Bluetooth off for initial RF tests.
RADIO CONTACTS RF header pins 1 and 16 and NC pin 6 have no carrier traces. DIO7 and DIO8 are reserved and unconnected in this revision. Manufacturer pinout image is an underside view. Socket numbering here follows the documented TOP view.
ENGINEERING PROTOTYPE Native KiCad ERC/DRC required; sample socket-fit checks pending. No hardware or radio performance has been validated. Do not substitute generic LM/AMS1117 for ceramic-stable TLV1117LV.

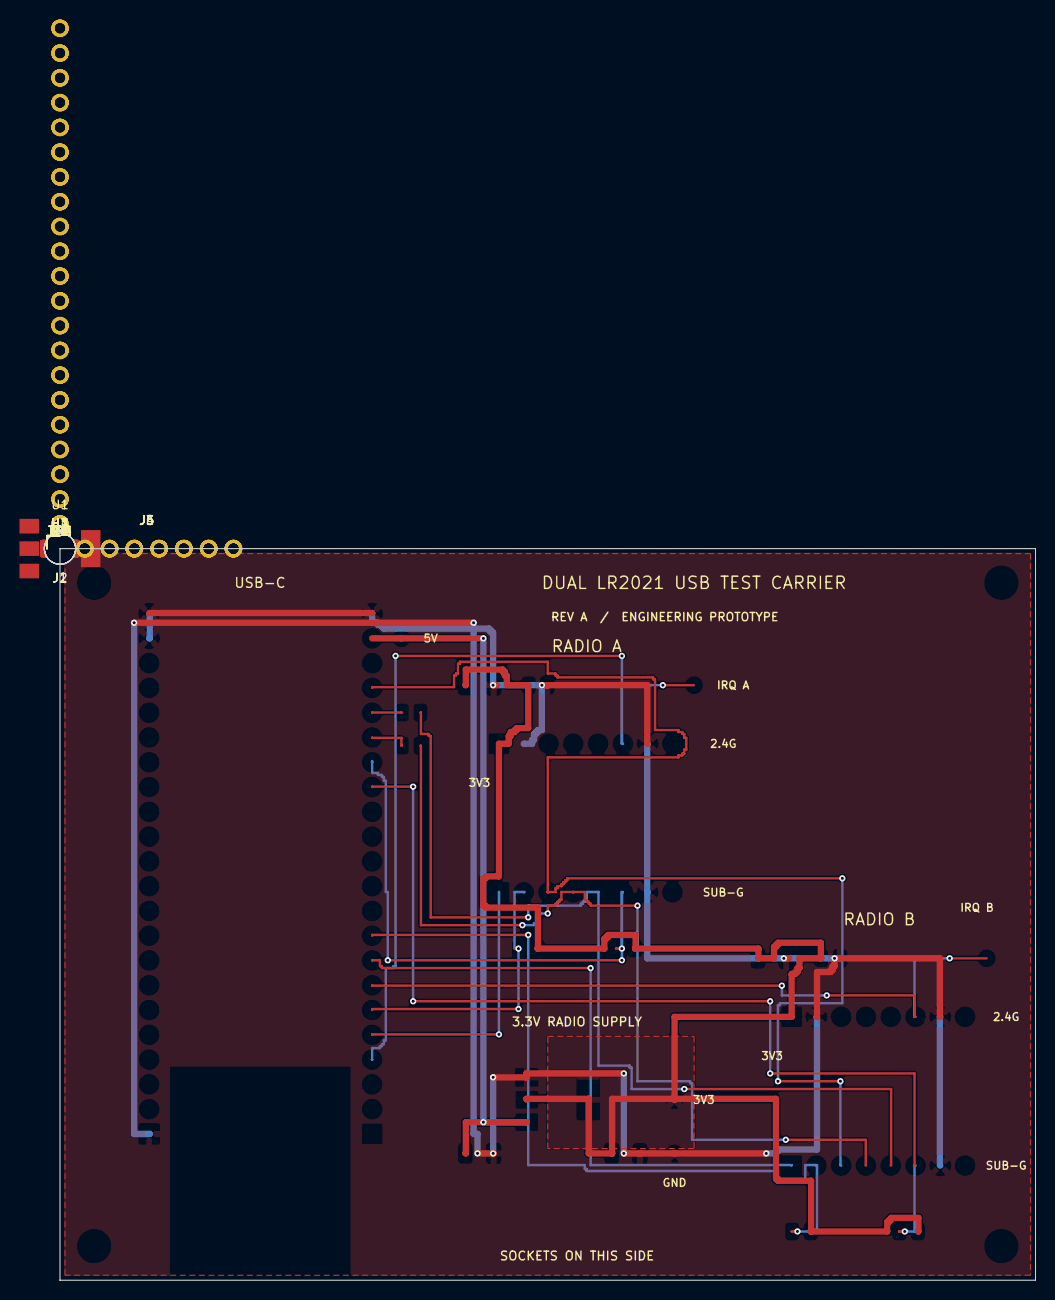
[picture p35: board dual-radio-carrier.kicad_pcb from above]

Board: 2 copper layers, 100.0 x 75.0 mm, 28 parts (0 on the bottom side), 16 nets.

Other parts of the board:
H1, H2, H3, H4: M3 NPTH; MountingHole_3.2mm
