the-Drunken-coder/dual-band-radio-lab/hardware/adapters/core2021-hf-m-rev-a/core2021-hf-m-rev-a.kicad_sch

## KiCad design hardware/adapters/core2021-hf-m-rev-a/core2021-hf-m-rev-a.kicad_sch (2026-09-30)

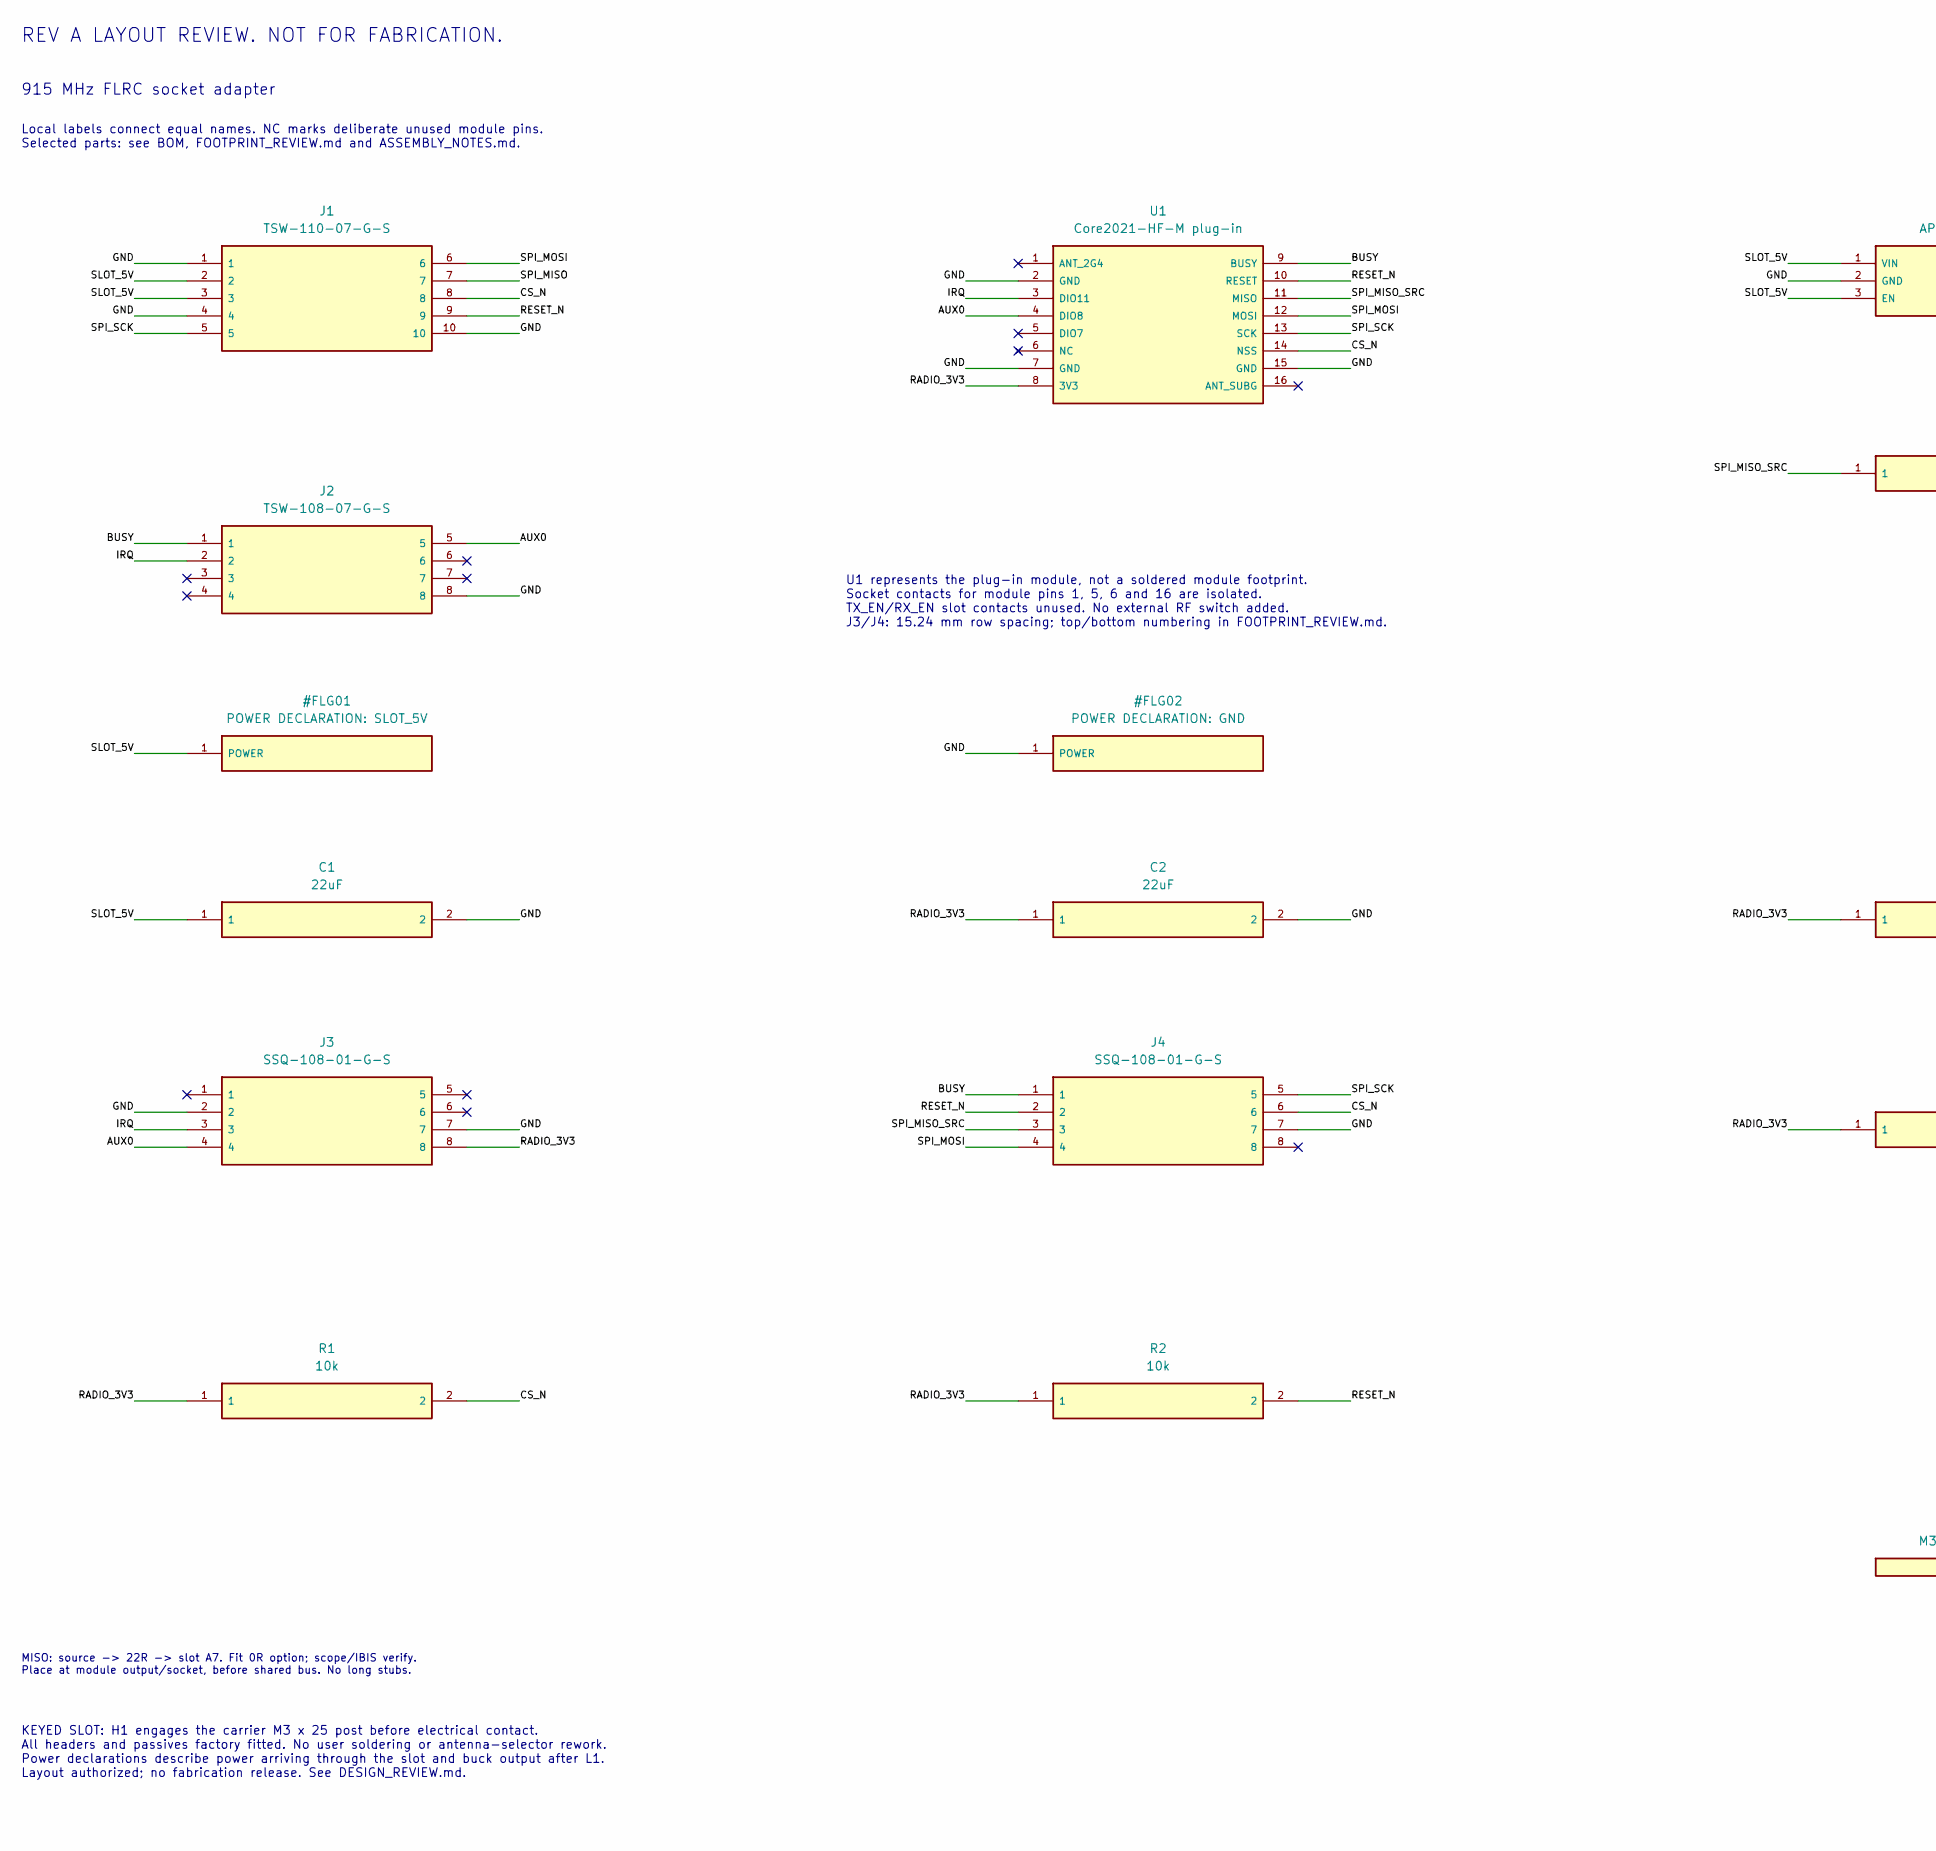
[picture p36: schematic core2021-hf-m-rev-a.kicad_sch, part in row 1, column 1]

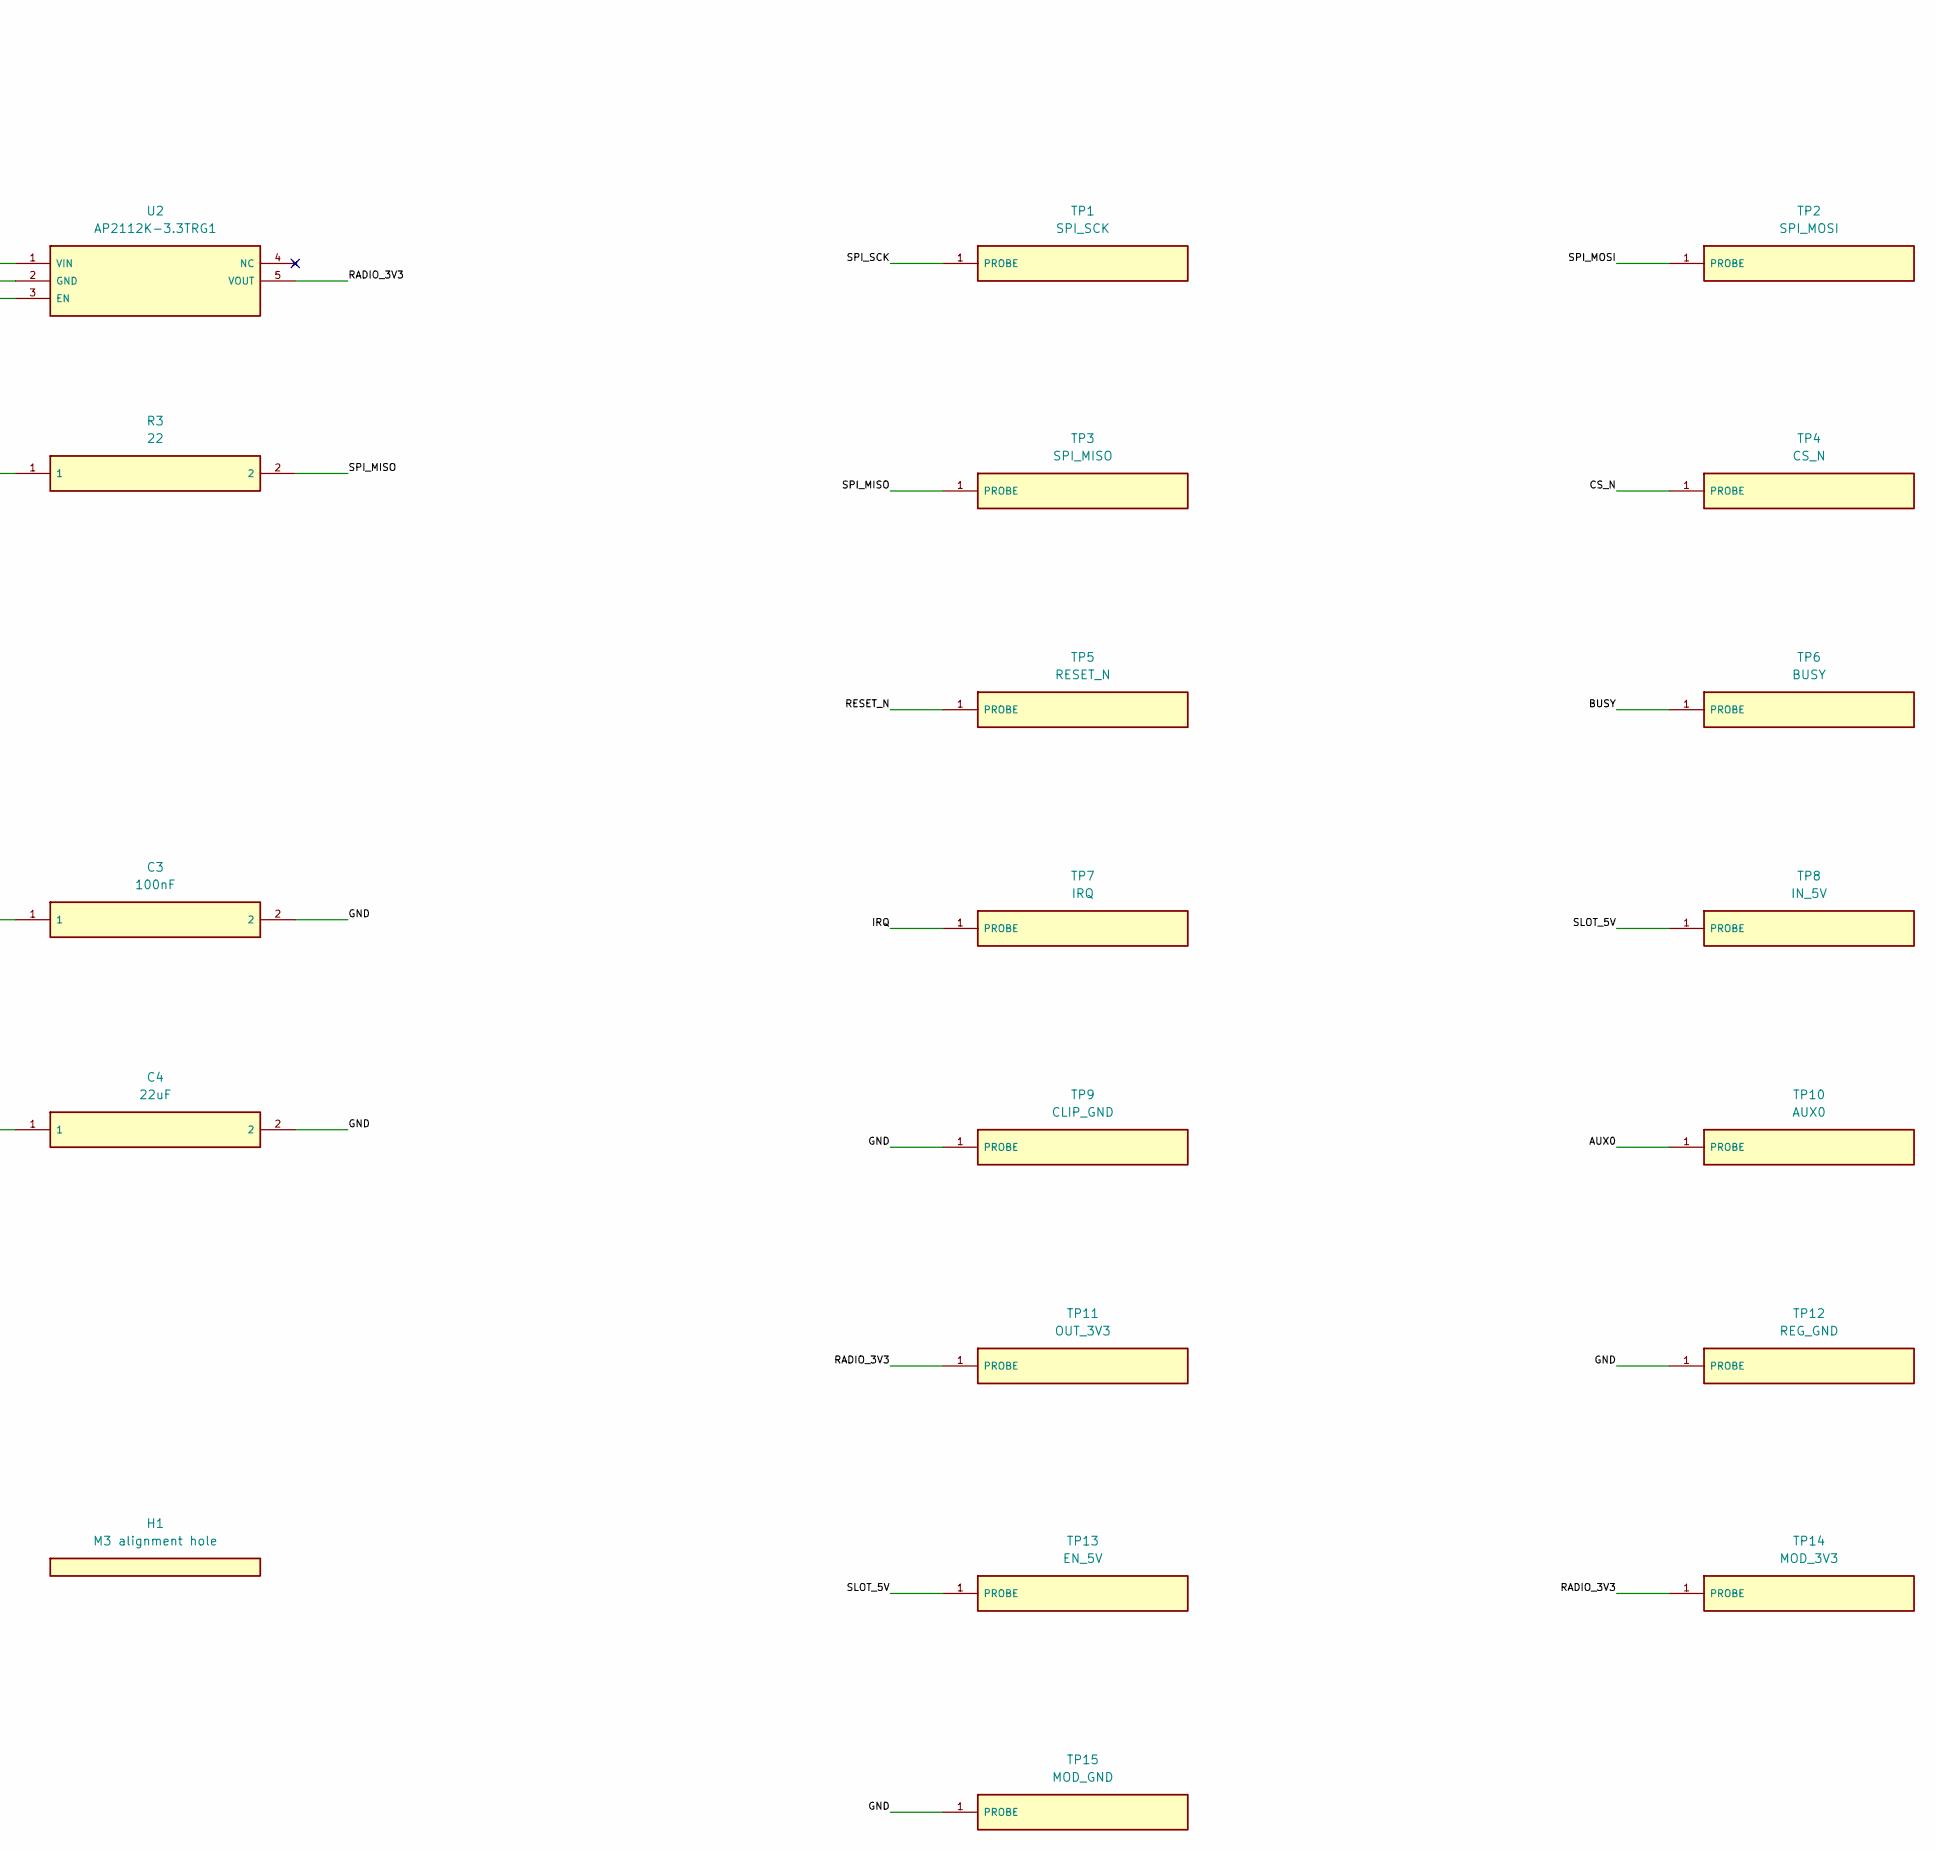
[picture p37: schematic core2021-hf-m-rev-a.kicad_sch, part in row 1, column 2]

Parts:
C1, C2, C4: 22uF; C_1210_3225Metric; MPN C3225X7R1E226M250AB
C3: 100nF; C_0603_1608Metric; MPN GRM188R71H104KA93D
H1: M3 alignment hole; Alignment_M3_3.4mm; MPN MECH-NPTH-3.4
J1: TSW-110-07-G-S; TSW_1x10; MPN TSW-110-07-G-S
J2: TSW-108-07-G-S; TSW_1x8; MPN TSW-108-07-G-S
J3, J4: SSQ-108-01-G-S; SSQ_1x8; MPN SSQ-108-01-G-S
R1, R2: 10k; R_0603_1608Metric; MPN RC0603FR-0710KL
R3: 22; R_0603_1608Metric; MPN RC0603FR-0722RL
TP1: SPI_SCK; Probe_Pad_D1.0mm; MPN PCB-PROBE-PAD
TP2: SPI_MOSI; Probe_Pad_D1.0mm; MPN PCB-PROBE-PAD
TP3: SPI_MISO; Probe_Pad_D1.0mm; MPN PCB-PROBE-PAD
TP4: CS_N; Probe_Pad_D1.0mm; MPN PCB-PROBE-PAD
TP5: RESET_N; Probe_Pad_D1.0mm; MPN PCB-PROBE-PAD
TP6: BUSY; Probe_Pad_D1.0mm; MPN PCB-PROBE-PAD
TP7: IRQ; Probe_Pad_D1.0mm; MPN PCB-PROBE-PAD
TP8: IN_5V; Probe_Pad_D1.0mm; MPN PCB-PROBE-PAD
TP9: CLIP_GND; TestPoint_Keystone_5010-5014_Multipurpose; MPN 5011
TP10: AUX0; Probe_Pad_D1.0mm; MPN PCB-PROBE-PAD
TP11: OUT_3V3; Probe_Pad_D1.0mm; MPN PCB-PROBE-PAD
TP12: REG_GND; Probe_Pad_D1.0mm; MPN PCB-PROBE-PAD
TP13: EN_5V; Probe_Pad_D1.0mm; MPN PCB-PROBE-PAD
TP14: MOD_3V3; Probe_Pad_D1.0mm; MPN PCB-PROBE-PAD
TP15: MOD_GND; Probe_Pad_D1.0mm; MPN PCB-PROBE-PAD
U1: Core2021-HF-M plug-in; MPN Core2021-HF-M
U2: AP2112K-3.3TRG1; SOT-23-5; MPN AP2112K-3.3TRG1

Connections:
AUX0: J2.5, J3.4, TP10.1, U1.4 (DIO8)
BUSY: J2.1, J4.1, TP6.1, U1.9 (BUSY)
CS_N: J1.8, J4.6, R1.2, TP4.1, U1.14 (NSS)
GND: C1.2, C2.2, C3.2, C4.2, J1.1, J1.4, J1.10, J2.8, J3.2, J3.7, J4.7, TP9.1, TP12.1, TP15.1, U1.2 (GND), U1.7 (GND), U1.15 (GND), U2.2 (GND)
IRQ: J2.2, J3.3, TP7.1, U1.3 (DIO11)
RADIO_3V3: C2.1, C3.1, C4.1, J3.8, R1.1, R2.1, TP11.1, TP14.1, U1.8 (3V3), U2.5 (VOUT)
RESET_N: J1.9, J4.2, R2.2, TP5.1, U1.10 (RESET)
SLOT_5V: C1.1, J1.2, J1.3, TP8.1, TP13.1, U2.1 (VIN), U2.3 (EN)
SPI_MISO: J1.7, R3.2, TP3.1
SPI_MISO_SRC: J4.3, R3.1, U1.11 (MISO)
SPI_MOSI: J1.6, J4.4, TP2.1, U1.12 (MOSI)
SPI_SCK: J1.5, J4.5, TP1.1, U1.13 (SCK)

Notes on the sheet:
U1 represents the plug-in module, not a soldered module footprint. Socket contacts for module pins 1, 5, 6 and 16 are isolated. TX_EN/RX_EN slot contacts unused. No external RF switch added. J3/J4: 15.24 mm row spacing; top/bottom numbering in FOOTPRINT_REVIEW.md.
MISO: source -> 22R -> slot A7. Fit 0R option; scope/IBIS verify. Place at module output/socket, before shared bus. No long stubs.
KEYED SLOT: H1 engages the carrier M3 x 25 post before electrical contact. All headers and passives factory fitted. No user soldering or antenna-selector rework. Power declarations describe power arriving through the slot and buck output after L1. Layout authorized; no fabrication release. See DESI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
REV A LAYOUT REVIEW. NOT FOR FABRICATION.
915 MHz FLRC socket adapter
Local labels connect equal names. NC marks deliberate unused module pins. Selected parts: see BOM, FOOTPRINT_REVIEW.md and ASSEMBLY_NOTES.md.
