the-Drunken-coder/dual-band-radio-lab/hardware/adapters/e28-2g4m27s-rev-a/e28-2g4m27s-rev-a.kicad_sch

## KiCad design hardware/adapters/e28-2g4m27s-rev-a/e28-2g4m27s-rev-a.kicad_sch (2026-09-30)

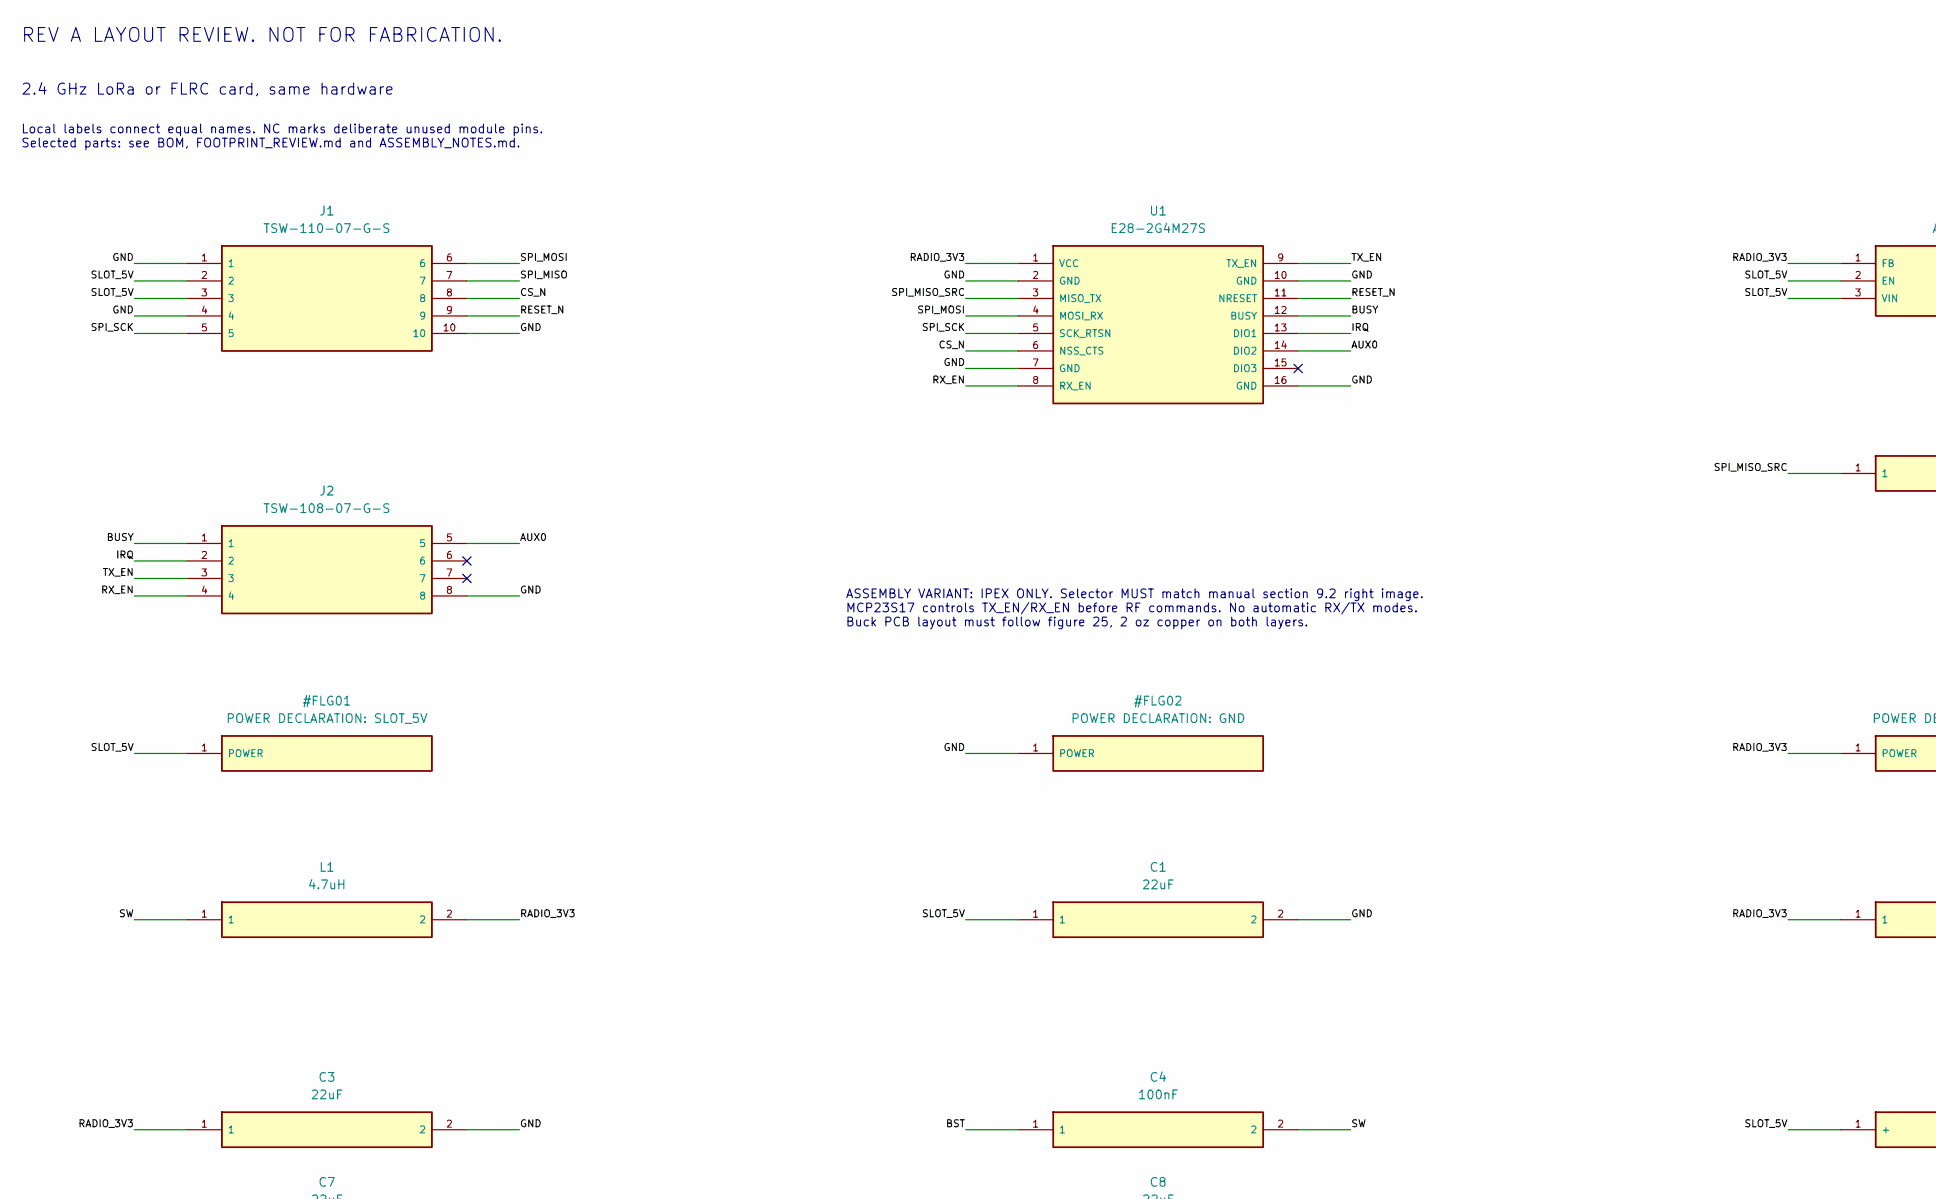
[picture p38: schematic e28-2g4m27s-rev-a.kicad_sch, part in row 1, column 1]

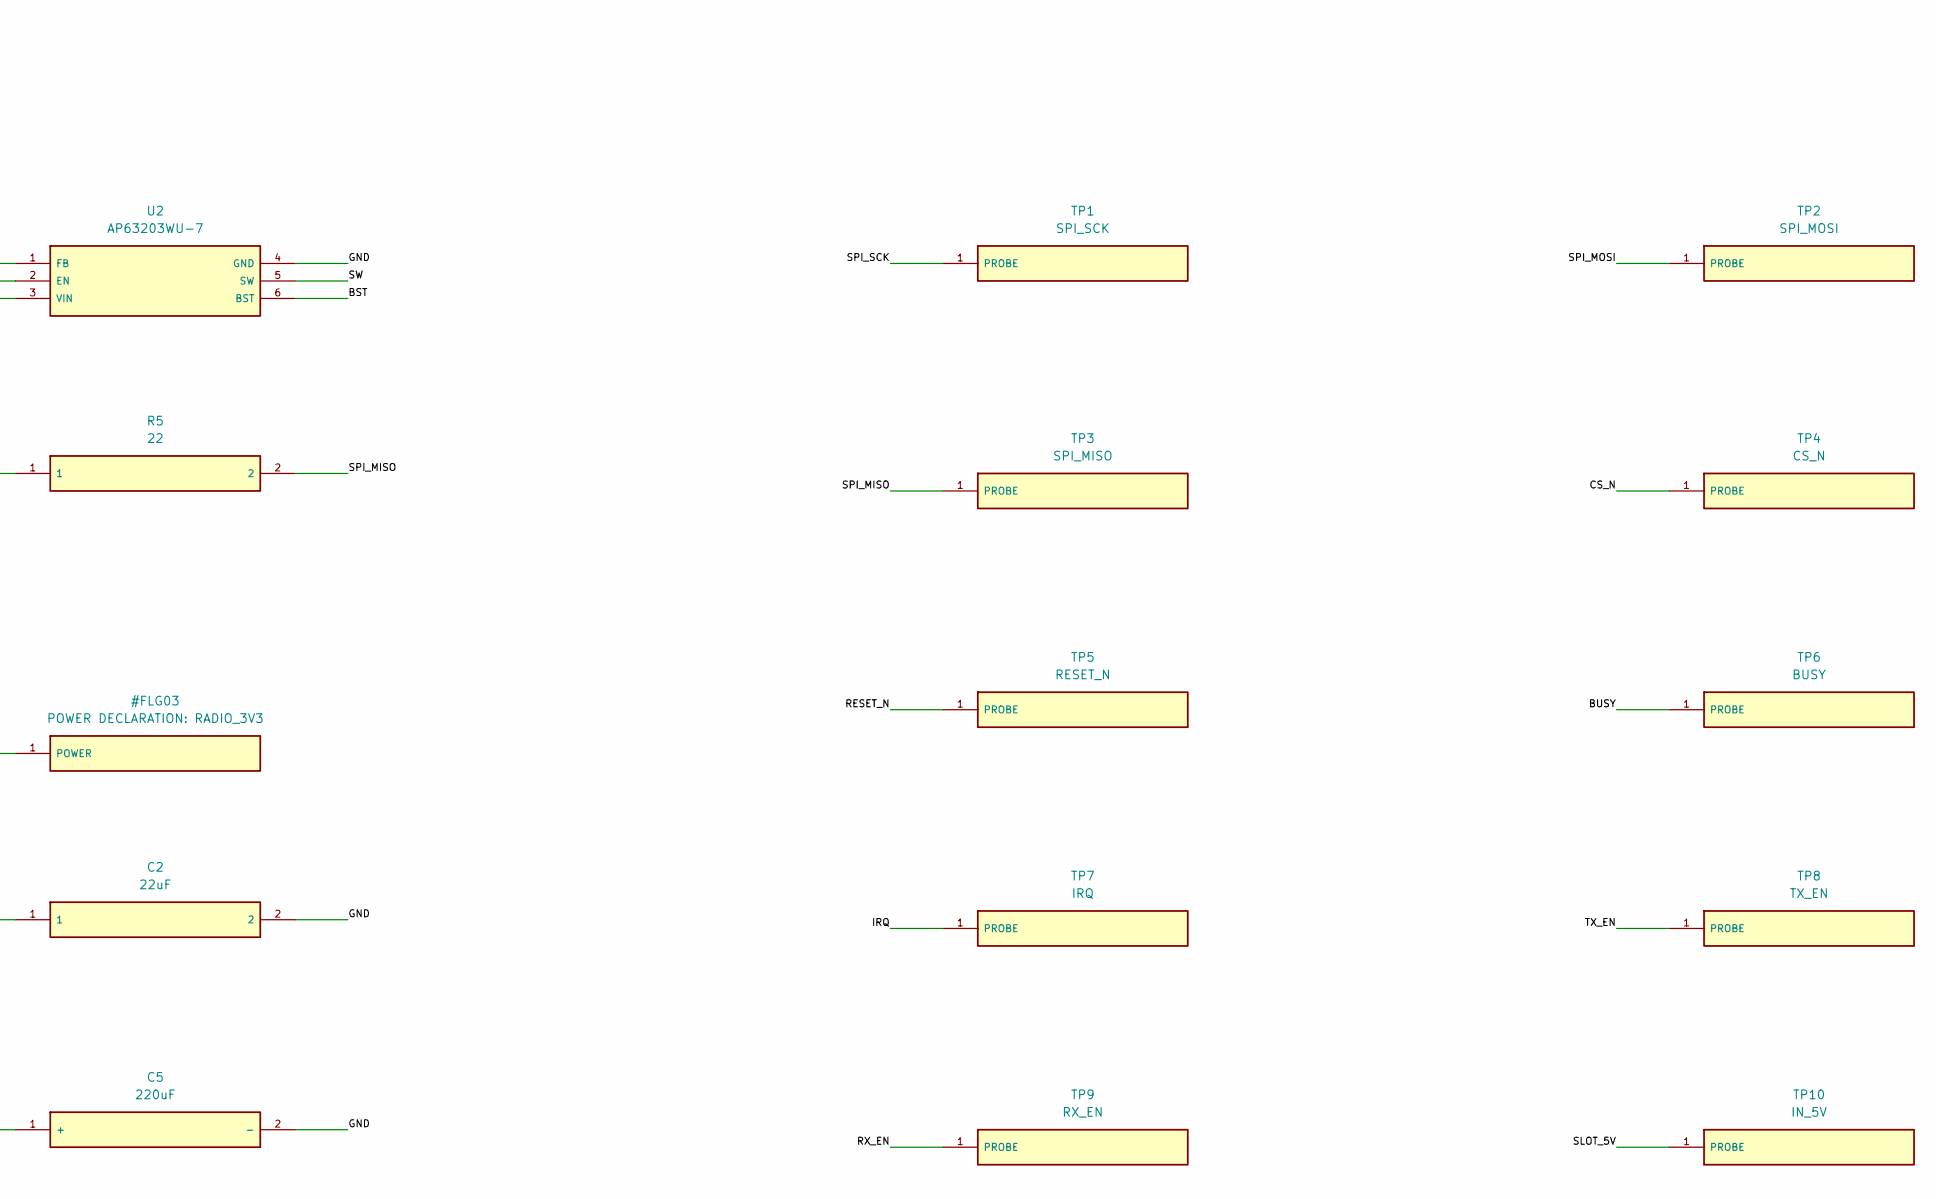
[picture p39: schematic e28-2g4m27s-rev-a.kicad_sch, part in row 1, column 2]

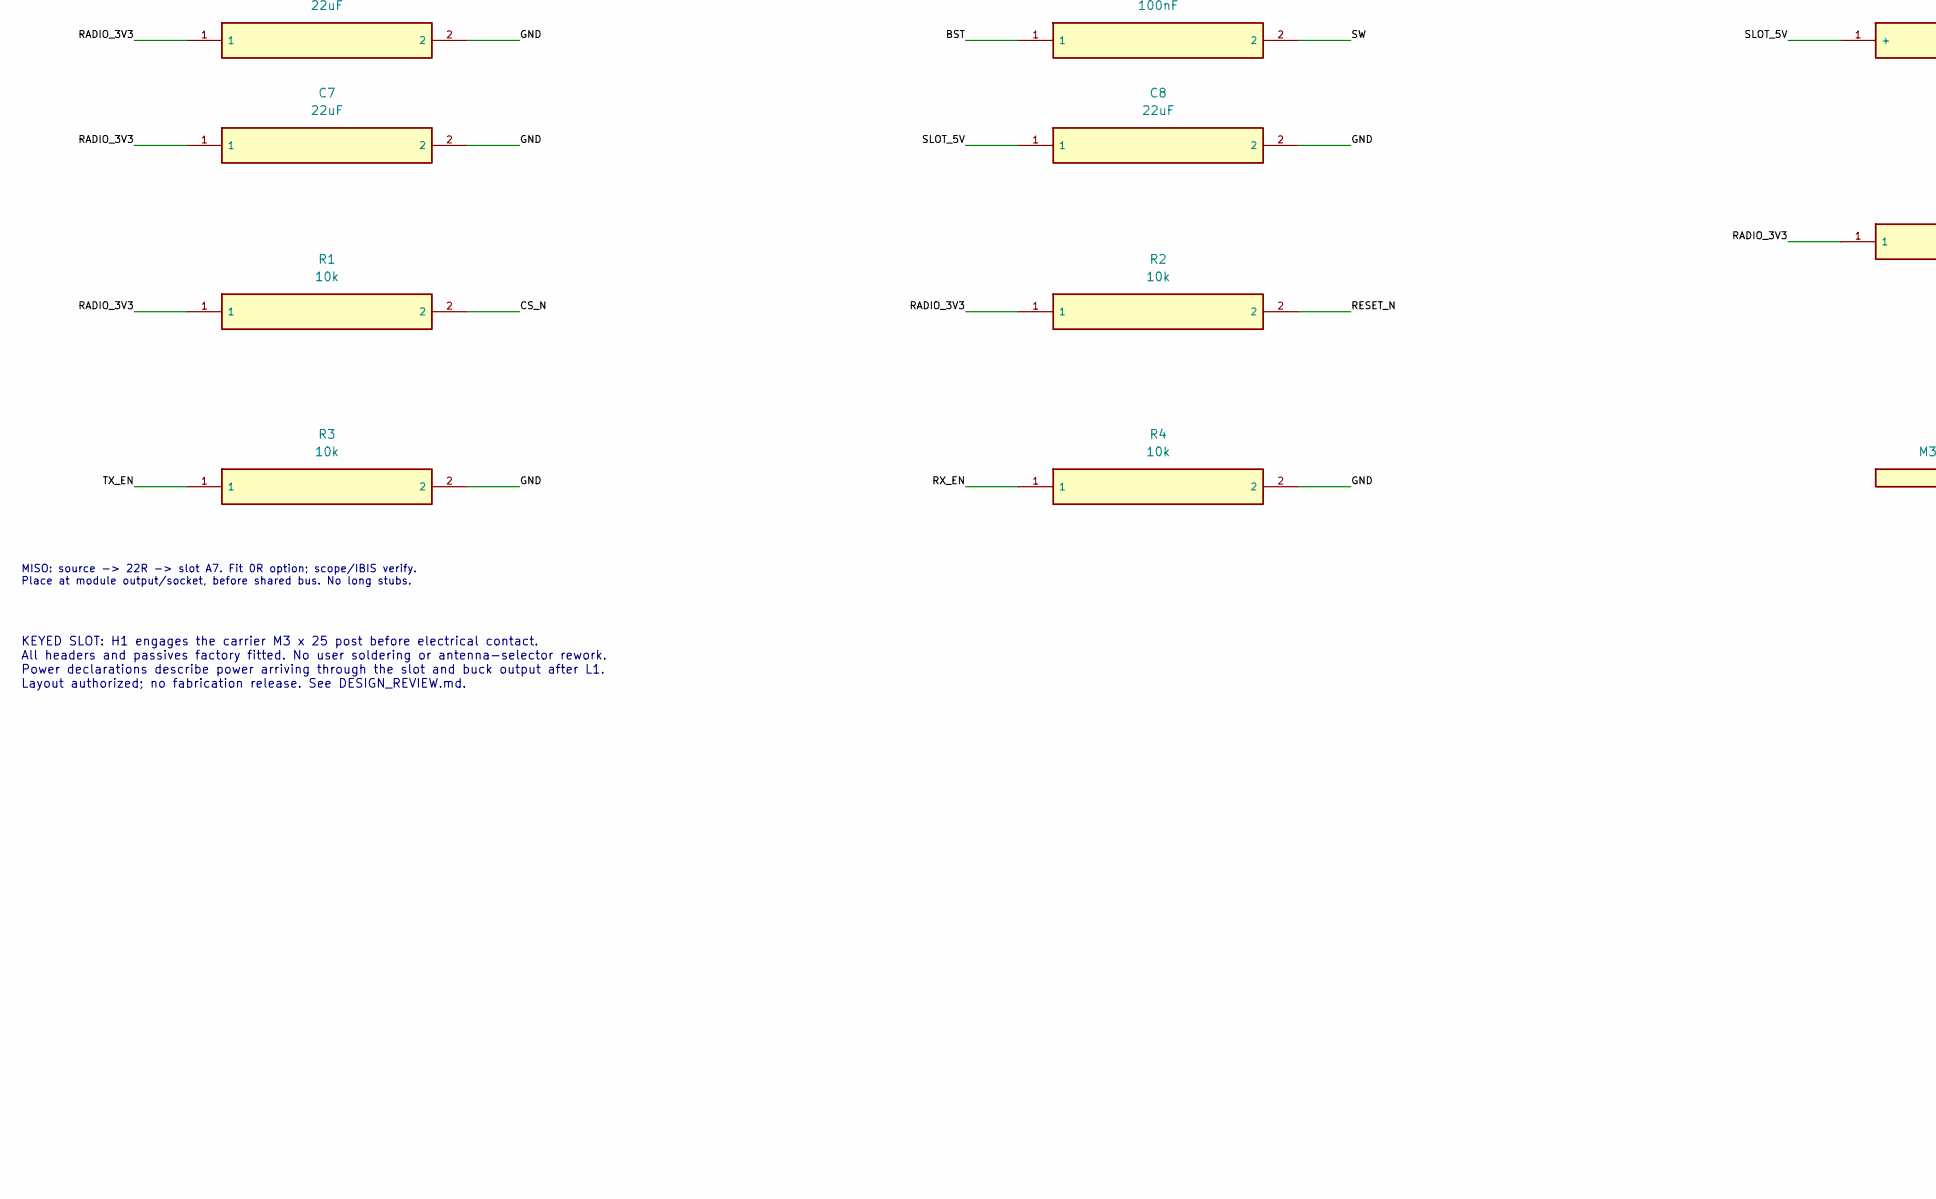
[picture p40: schematic e28-2g4m27s-rev-a.kicad_sch, part in row 2, column 1]

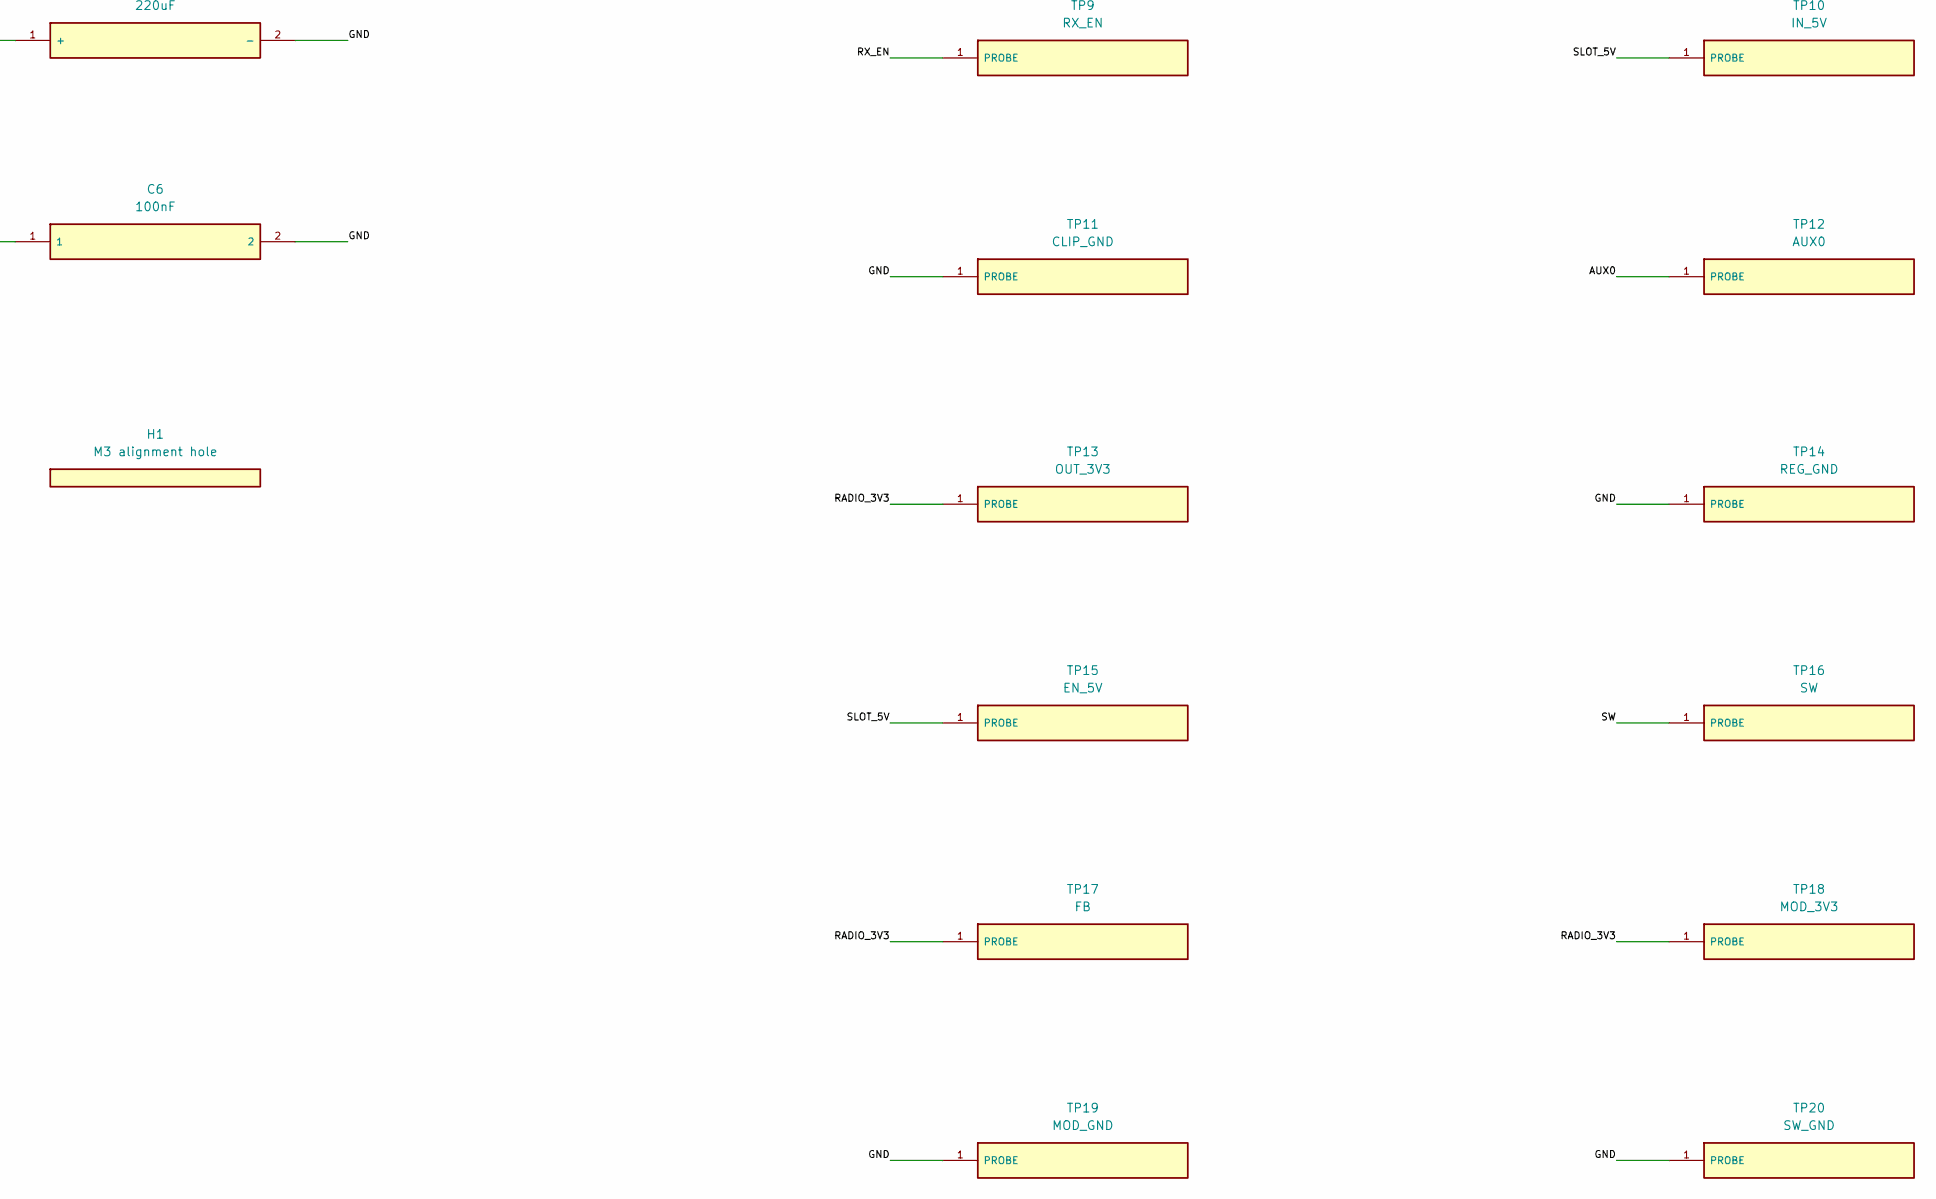
[picture p41: schematic e28-2g4m27s-rev-a.kicad_sch, part in row 2, column 2]

Parts:
C1, C2, C3, C7, C8: 22uF; C_1210_3225Metric; MPN C3225X7R1E226M250AB
C4, C6: 100nF; C_0603_1608Metric; MPN GRM188R71H104KA93D
C5: 220uF; Panasonic_FK_E_8x6.2; MPN EEEFK1A221P
H1: M3 alignment hole; Alignment_M3_3.4mm; MPN MECH-NPTH-3.4
J1: TSW-110-07-G-S; TSW_1x10; MPN TSW-110-07-G-S
J2: TSW-108-07-G-S; TSW_1x8; MPN TSW-108-07-G-S
L1: 4.7uH; L_Coilcraft_XAL5030-XXX; MPN XAL5030-472MEC
R1, R2, R3, R4: 10k; R_0603_1608Metric; MPN RC0603FR-0710KL
R5: 22; R_0603_1608Metric; MPN RC0603FR-0722RL
TP1: SPI_SCK; Probe_Pad_D1.0mm; MPN PCB-PROBE-PAD
TP2: SPI_MOSI; Probe_Pad_D1.0mm; MPN PCB-PROBE-PAD
TP3: SPI_MISO; Probe_Pad_D1.0mm; MPN PCB-PROBE-PAD
TP4: CS_N; Probe_Pad_D1.0mm; MPN PCB-PROBE-PAD
TP5: RESET_N; Probe_Pad_D1.0mm; MPN PCB-PROBE-PAD
TP6: BUSY; Probe_Pad_D1.0mm; MPN PCB-PROBE-PAD
TP7: IRQ; Probe_Pad_D1.0mm; MPN PCB-PROBE-PAD
TP8: TX_EN; Probe_Pad_D1.0mm; MPN PCB-PROBE-PAD
TP9: RX_EN; Probe_Pad_D1.0mm; MPN PCB-PROBE-PAD
TP10: IN_5V; Probe_Pad_D1.0mm; MPN PCB-PROBE-PAD
TP11: CLIP_GND; TestPoint_Keystone_5010-5014_Multipurpose; MPN 5011
TP12: AUX0; Probe_Pad_D1.0mm; MPN PCB-PROBE-PAD
TP13: OUT_3V3; Probe_Pad_D1.0mm; MPN PCB-PROBE-PAD
TP14: REG_GND; Probe_Pad_D1.0mm; MPN PCB-PROBE-PAD
TP15: EN_5V; Probe_Pad_D1.0mm; MPN PCB-PROBE-PAD
TP16: SW; Probe_Pad_D0.6mm; MPN PCB-PROBE-PAD
TP17: FB; Probe_Pad_D1.0mm; MPN PCB-PROBE-PAD
TP18: MOD_3V3; Probe_Pad_D1.0mm; MPN PCB-PROBE-PAD
TP19: MOD_GND; Probe_Pad_D1.0mm; MPN PCB-PROBE-PAD
TP20: SW_GND; Probe_Pad_D1.0mm; MPN PCB-PROBE-PAD
U1: E28-2G4M27S; E28_2G4M27S; MPN E28-2G4M27S
U2: AP63203WU-7; TSOT-23-6; MPN AP63203WU-7

Connections:
AUX0: J2.5, TP12.1, U1.14 (DIO2)
BST: C4.1, U2.6 (BST)
BUSY: J2.1, TP6.1, U1.12 (BUSY)
CS_N: J1.8, R1.2, TP4.1, U1.6 (NSS_CTS)
GND: C1.2, C2.2, C3.2, C5.2 (-), C6.2, C7.2, C8.2, J1.1, J1.4, J1.10, J2.8, R3.2, R4.2, TP11.1, TP14.1, TP19.1, TP20.1, U1.2 (GND), U1.7 (GND), U1.10 (GND), U1.16 (GND), U2.4 (GND)
IRQ: J2.2, TP7.1, U1.13 (DIO1)
RADIO_3V3: C2.1, C3.1, C6.1, C7.1, L1.2, R1.1, R2.1, TP13.1, TP17.1, TP18.1, U1.1 (VCC), U2.1 (FB)
RESET_N: J1.9, R2.2, TP5.1, U1.11 (NRESET)
RX_EN: J2.4, R4.1, TP9.1, U1.8 (RX_EN)
SLOT_5V: C1.1, C5.1 (+), C8.1, J1.2, J1.3, TP10.1, TP15.1, U2.2 (EN), U2.3 (VIN)
SPI_MISO: J1.7, R5.2, TP3.1
SPI_MISO_SRC: R5.1, U1.3 (MISO_TX)
SPI_MOSI: J1.6, TP2.1, U1.4 (MOSI_RX)
SPI_SCK: J1.5, TP1.1, U1.5 (SCK_RTSN)
SW: C4.2, L1.1, TP16.1, U2.5 (SW)
TX_EN: J2.3, R3.1, TP8.1, U1.9 (TX_EN)

Notes on the sheet:
ASSEMBLY VARIANT: IPEX ONLY. Selector MUST match manual section 9.2 right image. MCP23S17 controls TX_EN/RX_EN before RF commands. No automatic RX/TX modes. Buck PCB layout must follow figure 25, 2 oz copper on both layers.
MISO: source -> 22R -> slot A7. Fit 0R option; scope/IBIS verify. Place at module output/socket, before shared bus. No long stubs.
KEYED SLOT: H1 engages the carrier M3 x 25 post before electrical contact. All headers and passives factory fitted. No user soldering or antenna-selector rework. Power declarations describe power arriving through the slot and buck output after L1. Layout authorized; no fabrication release. See DESI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
REV A LAYOUT REVIEW. NOT FOR FABRICATION.
2.4 GHz LoRa or FLRC card, same hardware
Local labels connect equal names. NC marks deliberate unused module pins. Selected parts: see BOM, FOOTPRINT_REVIEW.md and ASSEMBLY_NOTES.md.
