the-Drunken-coder/dual-band-radio-lab/(commit log)

2026-09-17 Add Rev-A schematics and debug-first layout constraints
2026-09-17 Add configurable SPI source termination
2026-09-18 Add routed Rev-A PCB layouts and board review
2026-09-18 Improve Rev-A ground references and feedback routing
2026-09-30 docs: stage radio rollout behind measurement and spending gates
2026-09-30 docs: organize staged development around each individual radio
